c-lydia/SmartDB/smart_db_v2/smart_db/work/proposal.txt

                                                                 SmartDB ITC

 មាតិកា

   I.   ្របតិបត�ិសេង�ប (Executive Summary)………………………………………………………… 2
  II.   េសចក�ីែថ�ងពីប�� (Problem Statement)……………………………………………………… 2
 III.   ដំេណាះ្រសយ (Propose Solution)…………………………………………………………….. 3

        3.1 រេបៀបដំេណីរករៃនឧបករណ៏SmartDB…………………………………………………………………3

        3.2 អំពក
               ី ម�វ ិធទ
                       ី ូរស័ព�(Mobile App)…………………………………………………………………………4

        3.3 អ�ីែដលេធ�ីឲ្យ SmartDB ខុសពីឧបករណ៍ែផ្សងៗ……………………………………………………….5

 IV.    ែផនករគេ្រមាង (Project Plan)…………………………………………………………………..5
         4.1 ដំណាក់កលៃនគេ្រមាង……………………………………………………………………………….7
         4.2 តរងេពលេវលគេ្រមាង………………………………………………………………………………7

         4.3 ត្រម�វករធនធាន………………………………………………………………………………………..15

  V.    ភាគីពក់ព័ន� និងគំរូអជីវកម� (Stakeholders) …………………………………………………16
 VI.    ករ្រគប់្រគងហនិភ័យ (Risks Management)………………………………………………...20
VII.    ែផនករវយតៃម� (Evaluation Plan)……………………………………………………………21
VIII.   េសចក�ីសន�ិដ�ន (Conclusion)…………………………………………………………………..22
 IX.    ឧបសម�័ន� (Appendix)…………………………………………………………………………….22

                                                                         1|

                                                                                           SmartDB ITC

I.     ្របតប
           ិ ត�ស
               ិ េង�ប

      ប��ែខ្សេភ�ីងក�ុងផ�ះគឺជាមូលេហតុចម្បងមួយែដលនាំឲ្យមានអគ�ីភ័យេនតមលំេនដ�នេនកម�ុជា េដយក�ុង
      ឆា� ំ២០២៤ មានករណីអគ�ីភ័យធ�ន់ធ�រចំនួន ៦០២ ករណី ែដលេកីនេឡីងយា៉ងខ� ំងេធៀបេទនឹងឆា� ំមុនែដល
                          ់ តិកុ �ងសហគមន៏េលី្រគ�សរចំនួន ៤៣្រគ�សរបានបង�ញថា ៧៣.៨% ធា�ប់
      មាន៤៣២ ករណី ។ ករស�ងម
      ជួបប��ែខ្សេភ�ីង ប៉ុែន� ៦០.៥% មិនមាន្របព័ន�្រត�តពិនិត្យតមេពលេវលជាក់ែស�ង (Real-time
      Monitoring) េនេឡីយេទ។

      គេ្រមាងេនះបង�ញពី SmartDB ែដលជា្របព័ន�្រត�តពិនិត្យ និងករពរែខ្សេភ�ីងក�ុងផ�ះេដយេ្របីបេច�កវ ិទ្យោ
      IoT (Internet of Things) ែដល្រត�វបានរចនាេឡីងេដីម្បីរកេឃីញប��មុនេពលវក�យជាេ្រគាះថា�ក់។
      ្របព័ន�េនះរួមប��ូ លឧបករណ៍ចប់ស��ចរន� និងកេមរ៉ កេម� (Thermal Camera) ភា�ប់ជាមួយ
      Microcontroller ESP32, Firebase (Cloud Backend) និងកម�វ ិធីទូរស័ព� (Mobile Application) េដីម្បី
      ផ�ល់ករ្រត�តពិនិត្យតមេពលេវលជាក់ែស�ង និងករករពរេដយស�័យ្របវត�ិ។

      លក�ណៈពិេសសសំខន់ៗរួមមាន៖

      - ករ្រត�តពិនិត្យតមេពលេវលជាក់ែស�ងៃនចរន� និងសីតុណ�ភាព

      - ករជូនដំណឹងភា�មៗតមទូរស័ព�េនេពលរកេឃីញស�នភាពខុស្រប្រកតី

      - ករេបីកដំេណីរករឧបករណ៍កត់េសៀគ�ី (Circuit Breaker) េដយស�័យ្របវត�ិកុ �ងកំឡុងេពលមានប��
      ធ�ន់ធ�រ

      - ករចូលេ្របីេលខទំនាក់ទំនងសេ�ង�ះបនា�ន់េដយផា�ល់តមរយៈកម�វ ិធីទូរស័ព�

      តមរយៈករផ�ល់ករ្រពមានជាមុន និងករករពរេដយស�័យ្របវត�ិ ្របព័ន�េនះមានេគាលបំណងកត់បន�យ
                           � លមកពីែខ្សេភ�ីងេនតម្រគ�សរកម�ុជា និងជំរុញករេ្របី្របាស់ដំេណាះ្រសយ
      ហនិភ័យៃនអគ�ីភ័យែដលបណា
      សុវត�ិភាពផ�ះឆា�តៃវ (Smart Home Safety Solutions) ឲ្យកន់ែតទូលំទូលយ។

II.    េសចក�ែី ថ�ងពប
                   ី ��

       ប��ែខ្សេភ�ង
                ី ក�ុងផ�ះដូចជា ករផ�ុកេលស
                                        ី ទម�ន់ (Overloads), េសៀគ�ខ
                                                                  ី �ី (Short Circuits), ករេឡង
                                                                                              ី កេម�
       (Overheating) នង
                      ិ ករេលចធា�យចរន� (Current Leakage) គជា
                                                          ឺ មូលេហតុចម្បងៃនអគ�ភ
                                                                            ី ័យតមលំេន

                                                                                                          2|

                                                                                               SmartDB ITC

       ដ�ន។ េយាងតម្របភពព័ត៌មាន Cambodianess ករណីអគ�ីភ័យធ�ន់ធ�រេនកម�ុជាបានេកីនេឡីងយា៉ងខ� ំង
       ក�ុងឆា� ំ២០២៤ េដយមានរបាយករណ៍ចំនួន ៦០២ ករណី ែដលេកីនេឡីងយា៉ងខ� ំងេធៀបនឹងឆា� ំមុនែដល

                                           � លមកពីប��ែខ្សេភ�ីងដូចជា ករដំេឡីងមិន្រតឹម្រត�វ
       មានចំនួន ៤៣២ ករណី េដយមូលេហតុចម្បងបណា
       និងករេធ�ស្របែហស [1]។ប��ទំងេនះេ្រចីនែតេកីតេឡីងេដយគា�នករ្រពមានជាមុនេធ�ីឲ្យមា�ស់ផ�ះពិបាក
       រកេឃីញទន់េពលេវល។ ្របព័ន�ករពរែខ្សេភ�ីងែបប្របៃពណី ដូចជា ឧបករណ៍កត់េសៀគ�ី (Circuit
       Breakers) មាន្របតិកម�ែតេនេពលែដលប��េកីតេឡីងរួចេហីយប៉ុេណា�ះេហីយមិនផ�ល់ករ្រត�តពិនិត្យ
       តមេពលេវលជាក់ែស�ង ឬករជូនដំណឹងជាមុនេឡីយ។

       ករស�ង់មតិមួយែដលេធ�ីេឡីងេនក�ុងសង�ត់របស់ពួកេយីងេដយមានអ�កេឆ�ីយតបចំនួន ៤៣ នាក់ េដីម្បី
       កំណត់ប��ែខ្សេភ�ីងែដលមា�ស់ផ�ះកម�ុជាកំពុងជួប្របទះ បានបង�ញថា ៧៣.៨% ៃនអ�កេឆ�ីយតប (៤៣
       នាក់) បានរយករណ៍ថាធា�ប់ជួបប��ែខ្សេភ�ីងក�ុងផ�ះ។ ក�ុងចំេណាមអ�កេឆ�ីយតបចំនួន ៣៩ នាក់ែដលរង
       ផលប៉ះពល់េនះ ៣៥.៩% ធា�ប់ជួបប��េឡីងកេម�, ៤៥.៩% មានឧបករណ៍អគ�ិសនីខូចខត ឬបាក់ែបក,
       ២៩.៧% ធា�ប់ជួបករដច់េភ�ីងញឹកញាប់, ២៤.៣% ធុំកិ�នេឆះេចញពី្របព័ន�ែខ្សេភ�ីង និង ៥.៤% ធា�ប់ជួប
       េផ�កបេនា�រ ឬអគ�ីភ័យពីែខ្សេភ�ីង។ េលីសពីេនះេទៀត ៦០.៥% ៃនអ�កេឆ�ីយតបមិនមាន្របព័ន�្រត�តពិនិត្យ
       តមេពលេវលជាក់ែស�ងេទ េហយ                ី ំណងចង់មាន្របព័ន�្រត�តពន
                              ី ជាង៩០%បានបង�ញពប                       ិ ត
                                                                         ិ ្យែដលអចផ�ល់
       ទន
        ិ �ន័យតមេពលេវលជាក់ែស�ងេនេពលមានភាពខុស្រប្រកតេី កត
                                                          ី េឡង
                                                              ី ។

       ដូេច�ះ ចំបាច់្រត�វមាន្របព័ន�្រត�តពន
                                          ិ ត
                                            ិ ្យែខ្សេភ�ង
                                                      ី ឆា�តៃវេដយែផ�កេលប
                                                                        ី េច�កវ ិទ្យោ IoT ែដលអច្រត�តពន
                                                                                                      ិ ត
                                                                                                        ិ ្យ
       ្របព័ន�ែខ្សេភ�ង
                     ី ក�ុងផ�ះរបស់អ�កជាបន�បនា�ប់ រកេឃញ
                                                     ី ភាពខុស្រប្រកតដ
                                                                    ី ូចជា ករេឡង
                                                                                ី កេម�នង
                                                                                        ិ ផ�ល់ទន
                                                                                               ិ �ន័យ
       តមេពលេវលជាក់ែស�ងែដលជួយឲ្យមា�ស់ផ�ះដឹងពស
                                              ី � នភាពផ�ះជានច
                                                            ិ �។

III.   ដំេណាះ្រសយ

       េដីម្បេី ដះ្រសយប��អគ�ភ
                             ី ័យតមលំេនដ�នែដលបណា
                                                  � លមកពប
                                                        ី ��ែខ្សេភ�ង
                                                                   ី ដូចជា ែខ្សេភ�ង
                                                                                 ី េឡង
                                                                                     ី កេម�
       នង
        ិ ឥរយាបថខុ
            ិ      ស្រប្រកតរី បស់ឧបករណ៍ ពួកេយង      ី ូវដំេណាះ្រសយមួយែដលមានេឈ�ះថា
                                             ី សូមេស�ន
       SmartDB ែដលជា្របព័ន�្រត�តពន
                                 ិ ត
                                   ិ ្យ នង
                                         ិ ករពរែខ្សេភ�ង
                                                       ី ក�ុងផ�ះេដយេ្របប
                                                                        ី េច�កវ ិទ្យោ IoT ឆា�តៃវ ែដល្រត�វ
       បានរចនាេឡង
                ី េដីម្បរី កេឃញ
                              ី ស�នភាពែខ្សេភ�ង
                                             ី ែដលមានេ្រគាះថា�ក់កុ �ងេពលេវលជាក់ែស�ង នង
                                                                                      ិ េធ�ី
       អន�រគមន៍េដយស�័យ្របវត�ម
                             ិ ុនេពលវវ ិវត�ន៍េទជាអគ�ភ
                                                      ី ័យ។

       3.1 រេបៀបដំេណីរករៃនឧបករណ៏SmartDB

       SmartDB តមដន្របព័ន�ែខ្សេភ�ង
                                  ី ក�ុងផ�ះជាបន�បនា�ប់េដយេ្រប្រី បាស់ឧបករណ៍ចប់ស��ចរន� (Current
       Sensor - SCT-013-000) នង
                              ិ កេមរ៉ កេម� (Thermal Camera - MLX90640)។ ឧបករណ៍ចប់ស��

                                                                                                           3|

                                                                                  SmartDB ITC

ចរន�វស់ចរន�អគ�ិសនីែដលហូរតមេសៀគ�ីកុ �ងផ�ះខណៈែដលកេមរ៉ កេម�ចប់សមាសធាតុែដលេឡីងកេម�
ខ� ំង និងលំនា ំសីតុណ�ភាពខុស្រប្រកតី។

ទិន�ន័យែដល្របមូលបាន្រត�វបានដំេណីរករេដយMicrocontroller ESP32 និងវ ិភាគេដយេ្របីមូ៉ែដលរក
េឃីញភាពខុស្រប្រកតីេដយែផ�កេលីប��សិប្បនិមិ�ត (AI-based Anomaly Detection)។ ទិន�ន័យអគ�ិស

នីមួយៗ្រត�វបានវយតៃម�រកលំនា ំចរន�ខុស្រប្រកតី ខណៈែដលរូបភាពកេម�្រត�វបានវ ិភាគេដីម្បីកំណត់អត�
ស��ណចំណុចេក� (Hotspots)។ ្របព័ន� Jetson Nano ្រត�វបានេ្របីេដីម្បីគា ំ្រទករវ ិភាគកេម�ក្រមិត
ខ�ស់ និងដំេណីរករ AI។

េនេពលរកេឃីញស�នភាពខុស្រប្រកតី ្របព័ន�នឹងេផ�ីករជូនដំណឹង (Alert Notification) ភា�មៗេទកន់
មា�ស់ផ�ះតមរយៈកម�វ ិធីទូរស័ព�។ ្របសិនេបីប��ឈនដល់ក្រមិតធ�ន់ធ�រ ម៉ូឌុលប��ូ នត (Relay Module)
នឹងកត់ផា�ច់ថាមពលពីេសៀគ�ីែដលរងផលប៉ះពល់េដយស�័យ្របវត�ិ េដីម្បីករពរេ្រគាះថា�ក់ែដលអចេកីត
មាន និងកត់បន�យហនិភ័យែដលេកីតពីអគ�ីភ័យែខ្សេភ�ីង។

3.2 អំពក
       ី ម�វ ិធទ
               ី ូរស័ព�

កម�វ ិធទ
       ី ូរស័ព�ែដលភា�ប់មកជាមួយេនះេដីរតួជាចំណុច្របទក់ស្រមាប់មា�ស់ផ�ះក�ុងករេមល
                                                                             ី េឃញ
                                                                                 ី ពស
                                                                                    ី �ន
ភាព្របព័ន�ែខ្សេភ�ង
                ី របស់ពួកេគ។ វបង�ញតួរេលខករអនតៃម�ផា�ល់ (Live Readings) ៃនចរន� នង
                                                                                  ិ
 ិ �ន័យកេម� បង�ញករជូនដំណឹងអំពភា
ទន                              ី ពខុស្រប្រកតត
                                             ី មេពលេវលជាក់ែស�ង រួមជាមួយករចត់ថា�ក់
ប�� (Fault Classification) នង
                            ិ រក្សោទុកកំណត់េហតុៃនសកម�ភាពអគ�ស
                                                           ិ នក
                                                              ី ន�ងមក (Historical Log)
។ ក�ុងស�នភាពសេ�ង�ះបនា�ន់ កម�វ ិធេី នះក៏ផ�ល់េលខទំនាក់ទំនងសេ�ង�ះបនា�ន់េដយផា�ល់ ែដលអនុ��ត
ឲ្យមា�ស់ផ�ះអចទក់ទងេសវកម�ពក់ព័ន�បានយា៉ងរហ័សេដយ្រគាន់ែតចុចម�ងប៉ុេណា�ះ។

លក�ណៈពេិ សសសំខន់ៗ

- ករ្រត�តពន
           ិ ត
             ិ ្យជាបន�បនា�ប់ (Continuous Monitoring): វស់ចរន�អគ�ស
                                                                 ិ នក
                                                                    ី ុ �ងផ�ះតមេពលេវលជាក់
          ិ រ ំខនដល់ករផ�ត់ផ�ង់ថាមពល
ែស�ង េដយមន

- កររកេឃញ
         ី ចំណុចេក�កេម� (Thermal Hotspot Detection): កំណត់អត�ស��ណសមាសធាតុែដល
េឡង
  ី កេម�ខ� ំង មុនេពលវក�យជាេ្រគាះថា�ក់

- កររកេឃញ
         ី ភាពខុស្រប្រកតេី ដយប��សប
                                  ិ ្បនម
                                       ិ ិ�ត (AI Anomaly Detection): រកេឃញ
                                                                         ី លំនា ំប��
ែដលលក់កំបា ំង ែដល្របព័ន�កំណត់តៃម�ធម�ត (Threshold Systems) មន
                                                             ិ អចរកេឃញ
                                                                      ី បាន

- ករបំែបកេសៀគ�េី ដយស�័យ្របវត�ិ (Automatic Circuit Isolation): ប��ូ នត (Relay) កត់ផា�ច់
ថាមពលភា�មៗេនេពលរកេឃញ
                    ី ប�� េដយមន
                               ិ ចំបាច់មានករេធ�អ
                                                ី ន�រគមន៍ពអ
                                                           ី �កេ្រប្រី បាស់

                                                                                                4|

                                                                                     SmartDB ITC

- ករជូនដំណឹងតមេពលេវលជាក់ែស�ង (Real-time Alerts): េផ�ីករជូនដំណឹងរុញ (Push
Notifications) ភា�មៗេទកន់មា�ស់ផ�ះេនេពលរកេឃីញភាពខុស្រប្រកតី

- ករចូលេ្របីេលខទំនាក់ទំនងសេ�ង�ះបនា�ន់ (Emergency Contact Access): ចុចែតម�ងេដីម្បីេហេស
វសេ�ង�ះបនា�ន់េដយផា�ល់ពីកម�វ ិធី

- ករកត់្រត្របវត�ិទិន�ន័យ (Historical Data Logging): រក្សោទុកករអនតៃម� និងករជូនដំណឹងកន�ង
មកេនក�ុង Firebase ស្រមាប់ឲ្យមា�ស់ផ�ះពិនិត្យេឡីងវ ិញ

- ករទញេសចក�ីសន�ិដ�នែដលអចេធ�ីមា្រតដ�នបាន (Scalable Inference) Jetson Nano អនុ��ត
ឲ្យមានករទញេសចក�ីសន�ិដ�នពីមូ៉ែដល (Model Inference) ក្រមិតខ�ស់ ែដលេលីសពីសមត�ភាពរបស់
ESP32

3.3 អ�ែី ដលេធ�ឲ
             ី ្យ SmartDB ខុសពឧ
                              ី បករណ៍េផ្សងៗ

ឧបករណ៍កត់េសៀគ�ី (Circuit Breakers) ែបប្របៃពណីែដលមាន្របតិកម�ែតេនេពលែដលប��េកីត
េឡង
  ី រួចេហយ
         ី ប៉ុេណា�ះ េដយមន
                         ិ ផ�ល់ករស��្របាប់ជាមុនេឡយ
                                                  ី ។ ឧបករណ៍េដតឆា�តៃវ (Smart
Plugs) ស្រមាប់អ�កេ្រប្រី បាស់អច្រត�តពន
                                      ិ ត
                                        ិ ្យតមរន�េដតនម
                                                       ី ួយៗ ប៉ុែន�ខ�ះករករពរេដយស�័យ្របវត�ិ នង
                                                                                                ិ
ករ្រត�តពន
         ិ ត
           ិ ្យកេម�។ SmartDB រួមប��ូ លករ្រត�តពន
                                                ិ ត
                                                  ិ ្យចរន� នង
                                                            ិ កេម�ជាបន�បនា�ប់ ជាមួយនង
                                                                                     ឹ កររក
េឃញ
  ី ភាពខុស្រប្រកតេី ដយប��សប
                           ិ ្បនម
                                ិ �ត
                                   ិ (AI) េដីម្បច
                                                ី ប់ប��មុនេពលវេកន
                                                                 ី េឡង
                                                                     ី ជាេ្រគាះថា�ក់
បនា�ប់មកកត់ផា�ច់ថាមពលេដយស�័យ្របវត�ិ េដយមន
                                           ិ ចំបាច់មានករេធ�អ
                                                            ី ន�រគមន៍ពអ
                                                                       ី �កេ្រប្រី បាស់េឡី
យ។

IV. ែផនករគេ្រមាង
4.1 ដំណាក់កលៃនគេ្រមាង

           ឹ ្រត�វបានអនុវត�ជាដំណាក់កលជាេ្រចន
គេ្រមាងេនះនង                                ី េដីម្បធា
                                                    ី នាបាននូវករអភវិ ឌ្ឍ នង
                                                                           ិ ករវយតៃម�
្របកបេដយ្របព័ន�ៃន្របព័ន�្រត�តពន
                               ិ ត
                                 ិ ្យ នង
                                       ិ ករពរែខ្សេភ�ង
                                                      ី េដយេ្របប
                                                                ី េច�កវ ិទ្យោ IoT ែដលបានេស�េី ឡង
                                                                                               ី ។

ដំណាក់កលទី ១: ករកំណត់ប�� នង
                            ិ ករ្រសវ្រជាវ (Problem Identification and Research)

ករ្រសវ្រជាវអក្សរសល                           ិ ករស�ង់មតន
                   ិ ្ប ៍ (Literature Review) នង          ិ ង
                                                            ឹ ្រត�វបានេធ�េី ឡង
                                                                             ី េដីម្បក
                                                                                     ី ំណត់អត�
ស��ណប��សុវត�ភា       ី ក�ុងផ�ះទូេទ ដំេណាះ្រសយែដលមាន្រសប់ នង
            ិ ពែខ្សេភ�ង                                      ិ ត្រម�វកររបស់អ�កេ្រប្រី បា
ស់។ ព័ត៌មានែដល្របមូលបាននង
                        ឹ ្រត�វបានេ្របេី ដីម្បក
                                              ី ំណត់េគាលបំណងគេ្រមាង នង
                                                                     ិ ត្រម�វករ្របព័ន�។

                                                                                                 5|

                                                                                 SmartDB ITC

ដំណាក់កលទី ២: កររចនា្របព័ន� (System Design)

ស�បត្យកម�្របព័ន�ទ ំងមូល (System Architecture) សមាសធាតុែផ�ករង
                                                             ឹ (Hardware Components)
រចនាសម�័ន�មូលដ�នទន
                  ិ �ន័យ (Database Structure) នង
                                               ិ លំហូរករងររបស់កម�វ ិធទ
                                                                       ី ូរស័ព� (Mobile
Application Workflow) នង
                       ឹ ្រត�វបានរចនាេឡង
                                       ី ។ សមាសធាតុែផ�ករងដូ
                                                        ឹ ចជា ឧបករណ៍ចប់ស��
(Sensors), ESP32 នង
                  ិ យន�ករឧបករណ៍កត់េសៀគ�ី (Circuit Breaker Mechanisms) នង
                                                                         ឹ ្រត�វបាន
េ្រជីសេរសេដយែផ�
        ី        កេលត
                    ី ្រម�វករគេ្រមាង។

ដំណាក់កលទី ៣: ករអភិវឌ្ឍែផ�ករ ឹង ( Hardware Development)

ឧបករណ៍្រត�តពន
            ិ ត
              ិ ្យ (Monitoring Device) នង
                                        ឹ ្រត�វបានអភវិ ឌ្ឍេដយកររួមប��ូ លឧបករណ៍ចប់ស��
ចរន� នង
      ិ កេមរ៉ ចប់សត
                     ី ុណ�ភាពជាមួយMicrocontroller ESP32។ យន�ករឧបករណ៍កត់េសៀគ�ក
                                                                              ី ៏នង
                                                                                  ឹ ្រត�វ
បានប��ូ លផងែដរ េដីម្បីផ�ល់ករករពរេដយស�័យ្របវត�ិកុ �ងកំឡុងេពលមានស�នភាពែដលែខ្សេភ�ីងមាន
ប��អចបង�េទជាអគ�ីភ័យ ឬេ្រគាះថា�ក់េផ្សងៗ។
ដំណាក់កលទី ៤: ករអភិវឌ្ឍែផ�កទន់ ( Software Development)

កម�វ ិធីទូរស័ព� (Mobile Application) នឹង្រត�វបានអភិវឌ្ឍេដីម្បីបង�ញទិន�ន័យអគ�ិសនីតមេពលេវលជាក់
                       ំ ឹ ង (Alert Notifications) និងអនុ��តឲ្យអ�កេ្របី្របាស់ចូលេ្របីព័ត៌មាន
ែស�ង បំពក់ជាមួយករជូនដណ
ទំនាក់ទំនងសេ�ង�ះបនា�ន់។ Firebase នឹង Cloud Backend ស្រមាប់ករផ�ុកទិន�ន័យ និងករេធ�ីសមកល
កម� (Synchronization)។

ដំណាក់កលទី ៥: កររួមប��ូ ល្របព័ន� ( System Integration)

ឧបករណ៍ែផ�ករ ឹង (Hardware Device), មូលដ�នទិន�ន័យ Firebase និងកម�វ ិធីទូរស័ព� (Mobile
Application) នឹង្រត�វបានរួមប��ូ លគា� េដីម្បីបេង�ីតករទំនាក់ទំនងតមេពលេវលជាក់ែស�ងរវង្របព័ន�
្រត�តពិនិត្យ និងអ�កេ្របី្របាស់។

ដំណាក់កលទី ៦: ករេធ�ីេតស� និងវយតៃម� (Testing and Evaluation)

្របព័ន�នឹង្រត�វបានេធ�ីេតស�េ្រកមលក�ខណ�អគ�ិសនីេផ្សងៗ រួមទំងករផ�ុកេលីសទម�ន់ (Overload) និងករ
េឡីងកេម� (Overheating)។ ដំេណីរករៃនយន�ករ្រត�តពិនិត្យ (Monitoring), ករជូនដំណឹង (Alert)
និងករករពរ (Protection) នឹង្រត�វបានវយតៃម�េដយែផ�កេលីេពលេវលេឆ�ីយតប (Response
Time), ភាពេជឿជាក់ (Reliability) និងភាព្រតឹម្រត�វ (Accuracy)។

                                                                                               6|

                                                                                 SmartDB ITC

ដំណាក់កលទី ៧: ករវ ិភាគ និងឯកសរ (Analysis and Documentation)

លទ�ផលៃនករេធ�ីេតស�នឹង្រត�វបានវ ិភាគ និងចង្រកងជាឯកសរ។ ្របសិទ�ភាពៃន្របព័ន�ែដលបានេស�ីេឡីង
ក�ុងករែកលម�សុវត�ិភាពែខ្សេភ�ីងក�ុងផ�ះ និងកត់បន�យហនិភ័យនឹង្រត�វបានវយតៃម�។

4.2 តរងេពលេវលគេ្រមាង

4.3 ត្រម�វករធនធាន
1.    Hardware

     េលខ.រ       បេច�កវ ិទ្យោ               រូបភាព                       េគាលបំណង

        1        Jetson Orin Nano                                        ដំេណីរករ YOLO
                 Developer Kit                                           Inference ស្រមាប់ចប់
                                                                         យកកេម� (Thermal
                                                                         Detection) េលីប��ែខ្ស
                                                                         េភ�ីង

                                                                                          7|

                                    SmartDB ITC

2   កេមរ៉ កេម�            ប��ូ លទិន�ន័យ (Input)
    (Thermal Camera -        ស្រមាប់កររកេឃីញកេម�
    MLX90640)

3   ESP32 Developer Kit      ដំេណីរករ Firmware នង
                                                 ិ
    v1 (Expressive           ជា Edge Processor
    ESP32
    Microcontroller)

4   ថ� (Battery - 3.7V Li-   ផ�ត់ផ�ង់ថាមពលដល់
    ion 21700 ទំហំ           ESP32, ADS1115 នង
                                             ិ
    5000mAh)                 MLX90640 ក�ុងេពលដច់
                             េភ�ង
                                ី

                                             8|

                                                    SmartDB ITC

5   ម៉ូឌុលករពរករសកថ�                       សកថ�ពីចរន� 5V ករពរ
    (Charging                                  ករសកេលីស និងករ
    Protection Module -                        បេ�� ញថាមពលេលីស
    CN3791 ជាមួយករ
    ករពរ)

6   ឧបករណ៍បំែប�ងកមា� ំង                        បំែប�ងតង់ស្យុងថ�េឡង
                                                                 ី
    (Boost Converter -                               ី �ត់ផ�ង់ថាមពលេទ
                                               េដីម្បផ
    3.7V េទ 5V Boost)                         ប��ូ ល AMS1117

7   ឧបករណ៍ចប់ស��                              វស់ចរន�ចូល
    ចរន� (Current
    Sensor - SCT-013-
    000)

8   SmartDB Breakout       N/A (មិនទន់រចនា)   PCB េមស្រមាប់ភា�ប់ែផ�ក
    PCB (ផលិតតម                               ទំងអស់
    បំណង)
9   សមាសធាតុសកម� និង       N/A                 សមាសធាតុសកម� និងអ
    អកម�                                       កម�ស្រមាប់ SmartDB
                                               Breakout PCB

                                                                9|

                                                      SmartDB ITC

10   Relay - Omron                               កត់ផា�ច់ Main Power
     G5LE-1-E                                    Inputស្រមាប់ស�នភាព
                                                 អសន�

11   PCB Protection -                            ករពរបន�ះ PCB
     Acrylic Conformal                           Breakout ពស
                                                           ី ំេណីម
     Coating

12   ្របអប់ដក់              N/A (មិនទន់រចនា)   ្របអប់ស្រមាប់ករពរ
     (Enclosure - េបាះពុម�                       សមាសធាតុ
     3D តមបំណង េ្របី
     PETG Filament)

                                                                  10 |

                                       SmartDB ITC

13   ែខ្សេភ�ីង (Wires - ែខ្ស   ែខ្សេភ�ីង និងករករពរែខ្ស
     េភ�ីងេមក្រមិត             េភ�ីង
     450/750V, PG7
     Cable Glands, Heat
     Shrink Sleeving,
     Ferrule)

                                                11 |

                                                                                         SmartDB ITC

        14         Fastener(M3 brass                                              ស្រមាប់ដំេឡីង និងភា�ប់
                   standoffs, heat-set
                   inserts, stainless
                   screws)

2.     Software

         បេច�កវ ិទ្យោ                                   េគាលបំណង

        Arduino IDE          អភិវឌ្ឍន៍ Firmware ស្រមាប់ ESP32

        React Native         អភវិ ឌ្ឍន៍កម�វ ិធទ
                                              ី ូរស័ព� (Mobile Application)

        Firebase             Cloud Backend នង
                                            ិ Database
        Figma                រចនា UI/UX និងេធ�ីគំរូ (Prototyping)

        Git/GitHub           ្រគប់្រគងកំែណ (Version Control) និងករសហករ
                             (Collaboration)

        JavaScript           អភិវឌ្ឍន៍កម�វ ិធីទូរស័ព�

        C/C++                ស្រមាប់សរេសរកម�វ ិធី ESP32

3.3.    ធនធានមនុស្ស
       សមាជិក្រក�ម             តួនាទី                                    ទំនួលខុស្រត�វ

       េឆង លីឌីយា៉             អ�កដឹកនាំគេ្រមាង នង
                                                 ិ វ ិស�ករហដែវ          រចនាស�បត្យកម�្របព័ន�
                               រ(Project Lead & Hardware                 (System Architecture)
                               Engineer)

                                                                                                  12 |

                                                                                          SmartDB ITC

         លី នីហ៊ង                  អ�កអភិវឌ្ឍន៍សុសែវរ(Software           អភិវឌ្ឍន៍កម�វ ិធីទូរស័ព� និងករ
                                    Developer)                            រួមប��ូ ល Firebase (Mobile
                                                                          App Development,
                                                                          Firebase Integration)

         សុម
           ឹ ដវ ី                  វ ិស�ករែផ�ករង
                                                ឹ (Hardware               អភវិ ឌ្ឍន៍ នង
                                                                                      ិ សកល្បង
                                    Engineer) នង
                                               ិ េរៀបចំឯកសរ              ផលត
                                                                            ិ ផល(Hardware
                                                                          Development & Testing)

         រ៉ មា៉ករ៉               អ�ករចនាUX/UI                          រចនាចំណុច្របទក់កម�វ ិធី
                                                                          ទូរស័ព� (Mobile App
                                                                          Interface)
         រន
          ិ សុភារ ី                 អ�ករចនា នង
                                             ិ បេ�� ញគំរូ 3D              រចនា្របអប់ ឬសម្បកករពរ
                                                                          ស្រមាប់ឧបករណ៍
                                                                          (Enclosure Design)

3.    គេ្រមាងថវ ិក
     ករចំណាយេទេលីHardware

     េឈ�ះសមា�រ:        ភាពេជឿជាក់            បរមា
                                                ិ             តៃម�កុ �ង       តៃម�            ្របភពទញ
                                                                                                    ិ
                                              ណ               មួយឯក           សរុប
                                                               ត($)          ($)

 Jetson Orin            Confirmed            1                249$           249$             seedstudi
 Nano                                                                                         o
 Developer kit

 Thermal                Estimated            1                56.76$         56.76            AliExpres
 Camera                                                                      $                s
 (MLX90640)

                                                                                                      13 |

                                                        SmartDB ITC

ESP32             Estimated   1       5.08$     5.08$     Alibaba
Developer kit
v1 (Espressif
ESP32
microcontroller
)

Current Sensor    Estimated   1       3.45$     3.45$     AliExpres
(SCT-013-                                                 s
000)

SmartDB           Estimated   1       N/A       5-15$     JLCPCB
breakout PCB
(custom
build)

Passive           Confirmed   1 set   N/A       5-10$     KhmerES
Components
(for PCB
build)

Relay(Omron       Estimated   1       2.86$     2.86$     DigiKey
G5LE-1-E)

PCB protection    Estimated   1       12.99$    12.99     Amazon
(Acrylic                      can               $
Conformal
Coating)

Enclosure         Estimated   1       10-20$    10-       Amazon
(custom 3D                            (materi   20$
printing, PETG                        al and
filament)                             labor)

                                                                 14 |

                                                             SmartDB ITC

450/750V rated   Estimated        As      0.3-0.5$   0.3-      Alibaba
mains wiring                      need               0.5$
                                  ed

PG7 cable        Estimated        3       7.99$      7.99$     Amazon
glands

Heat shrink      Confirmed        As      1.25$      1.25$     KhmerES
sleeving                          need
                                  ed

Ferrule          Estimated        1 set   9.99$      9.99$     Amazon

Fastener(M3      Confirmed        1 set   3$         3$        KhmerES
brass
standoffs,
heat-set
inserts,
stainless
screws)

Boost            Estimated        1       4.47$      4.47$     AliExpres
Converter                                                      s

Battery          Estimated        4       5.50$      22$       Alibaba

Charging         Estimated        1       1.98$      1.98$     AliExpres
Protection                                                     s
Module

 ករចំណាយេទេលីSoftware: មិនមាន
 . ថវ ិក្រត�វចំណាយសរុប

                                                                      15 |

                                                                                       SmartDB ITC

       េឈ�ះ                           តៃម�សរុប

       Hardware Cost                     416$

       Software Cost                       0$

       Total Budget Summary              416$

V.     ភាគព
          ី ក់ព័ន� នង
                    ិ គំរូអជីវកម�
      1. អ�កទទួលផល្របេយាជន៍ចម្បង
      អ�កទទួលផល្របេយាជន៍ចម្បងៃនគេ្រមាងេនះគមា
                                          ឺ � ស់ផ�ះ នង
                                                     ិ ្រក�ម្រគ�សរែដលេ្រប្រី បាស់ SmartDB េដយ
      ផា�ល់៖
     - មា�ស់ផ�ះកម�ុជា (Cambodian Homeowners)៖ ទទួលបានករ្រត�តពន
                                                              ិ ត
                                                                ិ ្យតមេពលេវលជាក់ែស�ង
      (Real-time Monitoring), ករជូនដំណឹង (Alert Notifications) នង
                                                                 ិ ករករពរេដយស�័យ្របវត�ព
                                                                                          ិ េី ្រគាះ
      ថា�ក់ែខ្សេភ�ង
                  ី
     - ្រគ�សរែដលរស់េនតំបន់មាន្របជាជនេ្រចន
                                          ី (Families Living in Densely Populated Areas)៖ ទទួល
      បានអត�្របេយាជន៍ពក
                      ី ររកេឃញ           ី ទន់េដីមដំបូង ែដលកត់បន�យហនភ
                             ី ប��ែខ្សេភ�ង                             ិ ័យៃនអគ�ភ
                                                                               ី ័យផ�ះជា
      េ្រចន
          ី
     - អ�ករស់េនវ ័យចំណាស់ ឬអ�កែដលមន
                                   ិ សូវេចះបេច�កវ ិទ្យោ (Elderly or Less Tech-Savvy Residents)៖
      ទទួលបានសុវត�ភា
                  ិ ពបែន�មតមរយៈលក�ណៈពេិ សសឧបករណ៍កត់េសៀគ�េី ដយស�័យ្របវត�ិ (Automatic
      Circuit Breaker) សូម្បែី តេនេពលែដលមា�ស់ផ�ះមន
                                                  ិ េនក៏េដយ។

     2 . អ�កទទួលផល្របេយាជន៍បនា�ប់បន្សំ
      ភាគីពក់ព័ន�បនា�ប់បន្សំរួមមាន ជាងអគ�ិសនី (Electricians), អជា�ធរមូលដ�ន (Local Authorities)
      និងទីភា�ក់ងរេឆ�ីយតបសេ�ង�ះបនា�ន់ (Emergency Response Agencies) ែដលអចទទួលផល
      ្របេយាជន៍េដយ្របេយាលពី SmartDB៖
      - នាយកដ�នពន�ត់អគ�ីភ័យ៖ អចទទួលបានអត�្របេយាជន៍ពីករថយចុះៃនករណីអគ�ីភ័យែដលបណា
                                                                                � លមក
      ពីប��ែខ្សេភ�ីង
      - រដ�ភិបាលមូលដ�ន និងអជា�ធរ្រក�ង ៖ គាំ្រទដល់សុវត�ិភាពសធារណៈ និងគំនិតផ�ួចេផ�ីមទី្រក�ងឆា�តៃវ
      - ជាងអគ�ិសនី និងអ�កេម៉ ករអគ�ិសនី ៖ អចែណនាំ ឬដំេឡីង្របព័ន�េនះជូនមា�ស់ផ�ះ

                                                                                                  16 |

                                                                                           SmartDB ITC

      3. ករចូលរួមជាមួយភាគព
                          ី ក់ព័ន�
       មតែិ កលម�ពភា
                 ី គព       ឹ ្រត�វបាន្របមូលតមរយៈករស�ង់មតិ (Surveys), ករបង�ញគំរូ (Prototype
                    ី ក់ព័ន�នង
       Demonstrations) នង
                        ិ ករេធ�េី តស�េដយអ�កេ្រប្រី បាស់ (User Testing)។ មតែិ កលម�ែដល្របមូលបាន
       នង
        ឹ ្រត�វបានេ្រប្រី បាស់េដីម្បែី កលម�មុខងរ (Functionality), ភាពងយ្រស�លេ្របី (Usability) នង
                                                                                                 ិ ្របសទ
                                                                                                       ិ �
       ភាព (Effectiveness) ៃន្របព័ន�ែដលបានេស�េី ឡង
                                                 ី ។

VI.     ករ្រគប់្រគងហនភ
                       ិ ័យ

       គេ្រមាងេនះ្របឈមនង
                       ឹ ហនភ
                            ិ ័យចំនួន្របាំមួយ្របេភទ៖ បេច�កេទស ្របតប
                                                                  ិ ត�ក
                                                                      ិ រ ករ្រគប់្រគងគេ្រមាង ទី
       ផ្សោរ នង
              ិ ហរិ ��វត�ុ ។ ហនភ
                                ិ ័យនម
                                     ី ួយៗ្រត�វបានវយតៃម�ខងេ្រកមេនះតមលទ�ភាពេកត
                                                                                ី មាន នង
                                                                                       ិ ផលប៉ះ
       ពល់ រួមជាមួយយុទ�ស�ស�កត់បន�យែដល្រត�វគា�។

       បេច�កេទស

       • កររកមិនេឃីញកំហុស (false negative) េទះបីមានករផ្សំគា�ពី ML និង្រសទប់ច្បាប់ (rule-

       based) ក៏េដយ
       • ករបំពនសុវត�ិភាព DTLS ឬ PSK ែដលអចបណា
                                              � លឱ្យមានករវយ្របហរតមករចម�ងសរ
       (replay) ឬករែក�ងបន�ំពក្យប��បដិេសធ (override)
       • ករប៉ះទង�ិចេលីែខ្សប��ូ ន I2C ឬសំេឡងរ ំខនស��រវង ADS1115 និង MLX90640

       • ករបរជ័យៃនករដក់ឧបករណ៍ករពរ (isolation) េលី PCB រវងថាមពលចូល និងឧបករណ៍េ្របី

       ថាមពលទប
       • កំហុសកម�វ ិធី firmware ែដលបណា
                                     � លឱ្យេកីតមានករចប់េផ�ីមេឡីងវ ិញម�ងេហីយម�ងេទៀត ឬករេលច
       ធា�យmemory
       • ករែ្រប្រប�លៃនករគណនា (calibration) ែដល្រត�វករករែកត្រម�វក្រមិត្រពំែដនេឡីងវ ិញ

       ្របតិបត�ិករ

       • កំហុសក�ុងករផ�ុំេដយៃដក�ុងដំណាក់កលផលិតគំរូដំបូង

       • ករពន្យោរេពលក�ុងករទិញសមា�រៈ េដយសររយៈេពលនាំចូលេនកម�ុជា

       • ករេនឿយហត់របស់អ�កេ្របី្របាស់ េដយសរស��្រពមានមិនពិត (false positive)

       • ករដំេឡីងឧបករណ៍ែដល្រត�វករចំេណះដឹងែផ�កអគ�ិសនី ែដលមា�ស់ផ�ះភាគេ្រចីនមិនមាន

       • ករខ�ះខតខ្យល់េចញចូល្រគប់្រគាន់េនក�ុង្របអប់ឧបករណ៍ក�ុងស�នភាពេ្របី្របាស់ជាក់ែស�ង

                   � ញ/វ៉ យហ�យ (Wi-Fi) ក�ុងេពលដំេឡីងឧបករណ៍
       • ករផា�ច់បណា

                                                                                                      17 |

                                                                                      SmartDB ITC

  គេ្រមាង

  • ករយឺតយា៉វកលវ ិភាគេលីករបណុ � ះបណា
                                      � ល និងេផ� ងផា�ត់គំរូ AI
  • េពលេវលមិន្រគប់្រគាន់កុ �ងករសកល្បងឧបករណ៍មុនករបង�ញចុងេ្រកយ ឬករដក់ដំេណីរករ

  ទីផ្សោរ

  • ករទទួលយកទបេដយសរភាពមិនធា�ប់ស�ល់នឹងឧបករណ៍សុវត�ិភាពអគ�ិសនីែបបករពរទុកមុន

  • ភាពែ្រប្រប�លចំេពះតៃម�កុ �ង្រក�មអ�កេ្របី្របាស់េគាលេដ

  • ករ្របកួត្របែជងពីមា៉កយីេហែដលមានេឈ�ះក�ុងទីផ្សោ្រសប់ ែដលកំពុងព្រងីកេទេលីែផ�ក្រត�តពិនិត្យ

  ឆា�តៃវ
  • ករលំបាកក�ុងករកសងទំនុកចិត�កុ �ងនាមជាឧបករណ៍ថ�ីែដលេនមិនទន់មានភស�ុតងប��ក់ែផ�ក

  សុវត�ិភាព

  ហរិ ��វត�ុ

  •    ករែ្រប្រប�លតៃម�េ្រគឿងបនា�ស់ (Jetson Nano, MLX90640 សុទ�ែតជាសមា�រៈនាំចូល)
  •    ករចំណាយេលីករទក់ទញអតិថិជនេលីសពីករបា៉ន់ស�ន
  •    ក្រមត
           ិ តៃម� enterprise ែដលកំណត់ទបជាងតៃម�ផលត
                                                 ិ ផលពត
                                                      ិ ្របាកដ

  2. ករវយតៃម�ហនភ
                  ិ ័យ
  លទ�ភាព (Likelihood) នង
                       ិ ផលប៉ះពល់ (Impact) ្រត�វបានវយតៃម�េលមា
                                                             ី ្រតដ�នបក
                                                                       ី ្រមត
                                                                            ិ (ទប,
  មធ្យម, ខ�ស់) េដយែផ�កេលក
                         ី រចត់ត ំង្រក�មករងរ នង
                                                  ិ ករេ្របៀបេធៀបជាមួយគេ្រមាងែផ�ករង
                                                                                  ឹ IoT ្រស
  េដៀងគា�។ ក្រមត
               ិ ហនភ
                    ិ ័យ (Risk Level) ឆ�ុះប�� ំងពឥ
                                                 ី ទ�ព
                                                     ិ លរួមប��ូ លគា�ៃនលទ�ភាព នង
                                                                              ិ ផលប៉ះពល់។

                      Risk                         Category     Likelihood   Impact     Risk level

      False negative on fault detection            Technical    Medium        High        High

DTLS or PSK compromise enabling spoofed            Technical      Low         High      Medium
                       override
             Hand-assembly defects                Operational   Medium       Medium     Medium

            Component sourcing delay              Operational     High       Medium     Medium

                                                                                                 18 |

                                                                                     SmartDB ITC

               Operator alert fatigue               Operational    Medium    Medium     Medium

     Timeline slippage on AI model training            Project     Medium     High        High

               Low market adoption                     Market      Medium     High        High

            Component price volatility               Financial     Medium    Medium     Medium

        Electrical safety certification gap          Regulatory      Low      High      Medium

     Liability exposure on missed detection          Regulatory      Low      High      Medium

3. យុទ�ស�ស�កត់បន�យហនិភ័យ
តរងខងេ្រកមបង�ញពីករផ�ូផ�ងហនិភ័យអទិភាពខ�ស់ (High-priority Risks) នីមួយៗជាមួយនឹងយុទ�ស
      �ស�កត់បន�យ (Mitigation Strategy) ែដល្រត�វគា�។ យុទ�ស�ស�កត់បន�យជាេ្រចីន្រត�វបានេដះ្រសយ
      េដយផា�ល់េដយស�បត្យកម�្របព័ន� (System Architecture) ជាជាងេដយដំេណីរករ្រគប់្រគងពីខង
      េ្រក (External Process Controls) ែដលឆ�ុះប�� ំងពីករសេ្រមចចិត�រចនា (Design Decisions) ែដល
      េធ�ីេឡីងជាពិេសសេដីម្បីកត់បន�យហនិភ័យ។

         ហនភ
            ិ ័យ                                          ករកត់បន�យ
 False negative on fault    Rule-based safety layer operates independently of AI inference
       detection                   ensuring detection continues even if ML models underperform

 DTLS or PSK                Sequence-number-based replay prevention and per-node pre-
       compromise                  shared keys limit the blast radius of any single compromised
                                   credential
 Hand-assembly defects      Visual inspection and continuity testing performed before powering
                                   on each assembled board
 Component sourcing         Critical components ordered at project start with a two-week buffer
       delay                       before the assembly phase begins
 Operator alert fatigue     Operator feedback loop retrains the anomaly detection model,
                                   reducing false positive rate over time

                                                                                                 19 |

                                                                                       SmartDB ITC

 Timeline slippage on Ai      Base-tier model development prioritized ahead of enterprise-tier
       training                     features to protect the core delivery timeline

 Low market adoption          Pilot deployment with early-adopter households to generate case
                                    studies ahead of wider launch
 Component price              Multiple supplier quotes obtained in advanced enterprise tier pricing
       volatility                   includes a margin buffer
 Electrical safety            Early consultation with the relevant Cambodian electrical authority to
       certification gap            clarify compliance requirements
 Liability exposure           Clear documentation of system limitations and recommended use
                                    alongside, not as a replacement for existing safety equipment

៨. ែផនករវយតៃម�

             ិ ័�យសេ្រមចេជាគជ័យ
8.1 លក�ណៈវ ិនច

1. សមត�ភាពបេច�កេទស

   • ្របព័ន�រកេឃីញកំហុសអគ�ិសនីេដយមានភាព្រតឹម្រត�វយា៉ងតិច ៩០%

   • រុ ឺេឡ (relay) ដំេណីរករេដយស�័យ្របវត�ិកុ �ងរយៈេពលេឆ�ីយតបែដលអចទទួលយកបាន ភា�មៗបនា�ប់ពី

      កររកេឃីញកំហុស
            ំ ឹ ងតមទូរស័ព�្រត�វបានប��ូ នក�ុងរយៈេពលប៉ុនា�នវ ិនាទីបនា�ប់ពីកររកេឃីញភាពមិន្រប្រកតី
   • ករជូនដណ

   • ្របព័ន�ដំេណីរករជាបន�បនា�ប់េដយគា�នករបរជ័យែដលមិនបានរ ំពឹងទុក

2. បទពិេសធន៍អ�កេ្របី្របាស់

   • កម�វ ិធីទូរស័ព�្រត�វបានវយតៃម�ជាមួយលទ�ផលវ ិជ�មានេដយអ�កសកល្បងេដីម្បីបេង�ីនភាពងយ្រស�លេ្របី

      និងភាពច្បាស់លស់
   • មា�ស់ផ�ះអចយល់ និងេឆ�ីយតបេទនឹងស��្រពមានេដយមិនចំបាច់មានចំេណះដឹងបេច�កេទស

                                                                                                   20 |

                                                                                        SmartDB ITC

3. ករ្របមូលទិន�ន័យ

3.1 ទិន�ន័យ្របព័ន�

   • ករអនតួរេលខពីឧបករណ៍ចប់ស��(Sensor) ្រត�វបានកត់្រតជាប់លប់កុ �ង Firebase ក�ុងេពលសក

        ល្បង
   • េពលេវលេឆ�ីយតបរវងកររកេឃីញកំហុស និងករដំេណីរកររុ ឺេឡ្រត�វបានកត់្រត

   • លទ�ផលពីករេធ�ីេតស� និងសកល្បង្រត�វបានចង្រកងជាឯកសរ ស្រមាប់វ ិភាគ

3.2 ទិន�ន័យអ�កេ្របី្របាស់

   • ករស�ង់មតិមុន និងេ្រកយេ្របី្របាស់ េដីម្បីវស់ស�ង់ករផា�ស់បូ �រេលីករយល់ដឹង និងករេពញចិត�របស់អ�ក

        េ្របី្របាស់
   • ករសេង�តេមីលអ�កេ្របី្របាស់េ្របី្របាស់កម�វ ិធីទូរស័ព�កុ �ងេពលសកល្បង

3.3 វដ�មត្រិ តឡប់

   • ករែចករ ំែលកគំរូកម�វ ិធីដំបូងជាមួយអ�កេ្របី្របាស់សក�នុពល េហីយែកស្រម�លកររចនាេដយែផ�កេលីមតិ

        ្រតឡប់មុនេពលផលិតចុងេ្រកយ
   • ករ្របមូលចេម�យ
                 ី តបពអ
                      ី �កេ្រប្រី បាស់បនា�ប់ពវី គ�សកល្បងនម
                                                          ី ួយៗ តមរយៈក្រមងសំណួរខ�ៗ
                                                                                 ី
   • ករបង�ញលទ�ផលដល់ភាគព
                        ី ក់ព័ន�បនា�ប់ពក
                                       ី រសកល្បង នង
                                                   ិ ចង្រកងជាឯកសរនូវសំណូមពរស្រមាប់
        ករែកលម�នាេពលអនាគត

VIII.   េសចក�ស
            ី ន�ដ
               ិ �ន

        ប��អគ�ស
              ិ នក
                 ី ុ �ងផ�ះគជា
                           ឺ ហនភ
                                ិ ័យសុវត�ភា
                                        ិ ពកំពុងេកន
                                                  ី េឡង
                                                      ី េនកម�ុជា េដយករណីអគ�ភ
                                                                             ិ ័យបានេកន
                                                                                      ី េឡង
                                                                                          ី
        ពី ៤៣២ ករណី ដល់ ៦០២ ករណីក�ុងឆា� ំ ២០២៤ ែតមួយឆា� ំបុ៉េណា�ះ។ ប៉ុែន�ផ�ះភាគេ្រចន
                                                                                   ី េនែតពង
                                                                                           ឹ ែផ�ក
        េលី circuit breaker ែដលជាឧបករណ៍ែបប្របៃពណី ែដលមន
                                                      ិ មានករ្រពមានជាមុន នង
                                                                           ិ គា�នករ្រត�តពន
                                                                                          ិ ិ
        ត្យតមេពលេវលជាក់ែស�ង។

        SmartDB េដះ្រសយប��េនះេដយផា�ល់ តមរយៈករ្រត�តពន
                                                        ិ ត
                                                          ិ ្យចរន�អគ�ស
                                                                    ិ នជា
                                                                       ី បន�បនា�ប់ កររកេឃញ
                                                                                          ី
        ចំណុចេក�េដយ្របព័ន�កេម� នង
                                   ិ កររកេឃញ
                                            ី ភាពមន
                                                  ិ ្រប្រកតេី ដយ AI។ េនេពលែដលហនភ
                                                                                  ិ ័យ្រត�វបាន
        រកេឃញ                                       ិ ជូនដំណឹងភា�មៗដល់មា�ស់ផ�ះ េដយមន
            ី ្របព័ន�កត់ផា�ច់ថាមពលេដយស�័យ្របវត�ិ នង                               ិ ្រត�វករ
        ចំេណះដឹងបេច�កេទសពអ
                         ី �កេ្រប្រី បាស់េឡយ
                                           ី ។

                                                                                                  21 |

                                                                                      SmartDB ITC

       េដយមាន្រគ�សរែដលបានស�ង់មតិជាង ៩០% បានបង�ញចំណាប់អរម�ណ៍ចំេពះ្របព័ន�្រត�តពិនិត្យែបប
       េនះ ែដលប��ក់ថា SmartDB ពិតជាមានត្រម�វករ និងជាដំេណាះ្រសយែដលអចអនុវត�បានស្រមាប់
       មា�ស់ផ�ះេនកម�ុជា។

       ករអំពវនាវឱ្យចូលរួម

       ពួកេយីងសូមេគារពអេ�� ីញគណៈវ ិនិច�័យ អ�កែណនាំ និងភាគីពក់ព័ន� គាំ្រទដល់ករអភិវឌ្ឍ និងករដក់ឱ្យ
       ដំេណីរករៃន SmartDB ជាដំេណាះ្រសយដ៏ជាក់ែស�ង មានតៃម�សមរម្យ និងមានឥទ�ិពលវ ិជ�មានចំេពះ
       សុវត�ិភាពអគ�ិសនីកុ �ងផ�ះេនកម�ុជា។

       ជំហនបនា�ប់ភា�មៗរបស់េយីងគឺ៖

       • ប�� ប់ករផ្សោរភា�ប់ែផ�ករ ឹង និងករគណនាឧបករណ៍ចប់ស��

       • ប�� ប់ករអភិវឌ្ឍកម�វ ិធីទូរស័ព� និងករសកល្បងជាមួយអ�កេ្របី្របាស់

      • េធ�ីករសកល្បង្របព័ន�េពញេលញក�ុងលក�ខណ�កំហុសែក�ងេធ�ី

      • បង�ញលទ�ផល និងែកលម�្របព័ន�េដយែផ�កេលីលទ�ផលវយតៃម�

                                                              ិ គំរូដំបូង
      • ែស�ងរកមាគា៌ស្រមាប់ករទទួលយកក�ុងសហគមន៍ទូលំទូលយជាងករផលត

      ជាមួយករគាំ្រទ្រតឹម្រត�វ SmartDB មានសក�នុពលឈនផុតពីដំណាក់កលគំរូដំបូង េហីយក�យជា
      ឧបករណ៍សុវត�ភា
                ិ ពែដលអចចូលេ្របបា
                                ី នពត
                                    ិ ្របាកដស្រមាប់្រគ�សរេនទូទ ំង្របេទសកម�ុជា កត់បន�យអគ�ិ
      ភ័យអគ�ស
            ិ នី ករពរ្រគ�សរ នង
                                ិ េលក
                                    ី កម�ស់ផ�ះែដលឆា�តៃវ នង
                                                         ិ មានសុវត�ភា
                                                                  ិ ពជាងមុន។

IX.     ឧបសម�័ន� (Appendix)
1. េសចក�ីសេង�បករស�ង់មតិ និងទិន�ន័យេដីម

                                                                                                22 |

SmartDB ITC

       23 |

                                                                                       SmartDB ITC

2. ស�បត្យកម�្របព័ន�

SmartDB មានស�បត្យកម�្របាំ្រសទប់៖

្រសទប់ចប់ស�� (Sensing Layer)

•     ឧបករណ៍ចប់ស��ចរន� SCT-013-000 វស់ចរន�អគ�ស
                                               ិ នក             ិ រ ំខនដល់ករផ�ត់ផ�ង់ថាមពល
                                                  ី ុ �ងផ�ះេដយមន
•     កេមរ៉ កេម� MLX90640 ថតចប់ករែចកចយកេម�ជាបន�បនា�ប់េនទូទ ំង្របព័ន�អគ�ស
                                                                                ិ នី

្រសទប់ដំេណីរករែគម (Edge Processing Layer)

•     ម្រី ក�កុន្រត�ល ESP32 ដំេណីរករទន
                                      ិ �ន័យចូលពឧ
                                                ី បករណ៍ចប់ស��
•     ្រសង់លក�ណៈអគ�ស
                   ិ នស
                      ី ំខន់ៗ នង
                                ិ តមដនករអនតៃម�េធៀបនង
                                                       ឹ ្រពំែដនសុវត�ភា
                                                                    ិ ព
•     ដំេណីរករកត់ផា�ច់រុេឡេដយស�
                           ឺ       ័យ្របវត�ភា
                                           ិ � មៗ ្របសន
                                                      ិ េបក
                                                          ី រអនតៃម�ណាមួយេលស
                                                                           ី ក្រមត
                                                                                 ិ សុវត�ភា
                                                                                       ិ ព

្រសទប់សន�ដ
          ិ � ន AI (AI Inference Layer)

•     គំរូ Isolation Forest រកេឃញ
                                ី លំនា ំមន
                                         ិ ្រប្រកតក
                                                  ី ុ �ងទន
                                                         ិ �ន័យអគ�ស
                                                                 ិ នី
•     គំរូ YOLO កំណត់អត�ស��ណចំណុចេក�ក�ុងរូបភាពកេម�
•     មា៉សុន
           ី ប��ូ លគា� (fusion engine) ផ្សំលទ�ផលទំងពរី េទជាពន
                                                              ិ ុ �ហនភ
                                                                      ិ ័យែតមួយ
•     Jetson Nano េដះ្រសយករសន�ដ
                                 ិ � នគំរូក្រមត
                                              ិ ខ�ស់េដីម្បភា
                                                          ី ព្រតម
                                                                ឹ ្រត�វខ�ស់ជាង

                                                                                              24 |

                                                                                    SmartDB ITC

្រសទប់ទំនាក់ទំនង (Communication Layer)

•       ESP32 ប��ូ នទិន�ន័យេទ Firebase តមេពលេវលជាក់ែស�ងតមរយៈ WiFi
•       Firebase រក្សោទុកករអនតៃម�ផា�ល់ ស��្រពមាន និងកំណត់្រត្របវត�ិកុ �ងពពក

្រសទប់កម�វ ិធី (Application Layer)

•       កម�វ ិធីទូរស័ព�បង�ញករអនតៃម�អគ�ិសនី និងកេម�ផា�ល់
•       េផ�ីស��្រពមានភា�មៗដល់មា�ស់ផ�ះេនេពលរកេឃីញភាពមិន្រប្រកតី
•       ផ�ល់ករចូលេ្របីទំនាក់ទំនងបនា�ន់្រតឹមែតមួយចុចក�ុងស�នភាពអសន�

                                                ប�ង់េសៀគ�ីអគ�ិសនី

3. កលវ ិភាគ

                    ដំណាក់កល                        រយៈេពល          កលបរ ិេច�ទ

    ដំណាក់កលទី ១: ្រសវ្រជាវ                       ៤ សបា�ហ៍        ឧសភា - មិថុនា

                                                                                           25 |

                                                                                  SmartDB ITC

 ដំណាក់កលទី ២: រចនា្របព័ន�                      ៤ សបា�ហ៍   ឧសភា - មិថុនា

 ដំណាក់កលទី ៣: អភិវឌ្ឍន៍ហដែវរ                  ២.៥ ែខ     កក�ដ - ក��

 ដំណាក់កលទី ៤: អភិវឌ្ឍន៍សុសែវរ                  ២.៥ ែខ     កក�ដ - ក��

 ដំណាក់កលទី ៥: រួមប��ូ ល្របព័ន� (Integration)   ២ សបា�ហ៍        ក��

 ដំណាក់កលទី ៦: េធ�ីេតស�                           ១ ែខ          តុល

 ដំណាក់កលទី ៧: វ ិភាគ និងឯកសរ                  ២ សបា�ហ៍    តុល - វ ិច�ិក

ឯកសរេយាង

[1] Cambodianess, ‘Fire Surge in Cambodia: 602 cases, 15 Dead in 8 Months,’ Cambodianess,
     2024. [Online]. Available: https://cambodianess.com/article/fire-surge-in-cambodia-602-
     cases-15-dead-in-8-months

                                                                                               26 |
