c-lydia/SmartDB/docs/reference/language_ref/preprocessor.md

# Preprocessor

Preprocessor: program that processes source code before compilation

## File Inclusion

``` c
#include "filename" // use when the file exists locally
#include <filename> // use for the standard C libraries
```

## Macro Substitution

``` c
#define name replacement_text
```

`name` will be replaced by `replacement_text` like how you assign values to variable

A long definition can be written by using a `\` at the end of the line

Substitution doesn't work for quoted string

``` c
#define forever for (;;) // infinite loop
#define max(a, b) ((a) > (b) ? (a) : (b)) 
/* looks like function invocation, but a and b will be replaced by values, e.g., x = max((p + q), (r + s)); will be replaced by x = ((p + q) > (r + s) ? (p + q) : (r + s)); */
```
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
