c-lydia/SmartDB/smart_db_v2/smart_db/work/back_labels_current.png

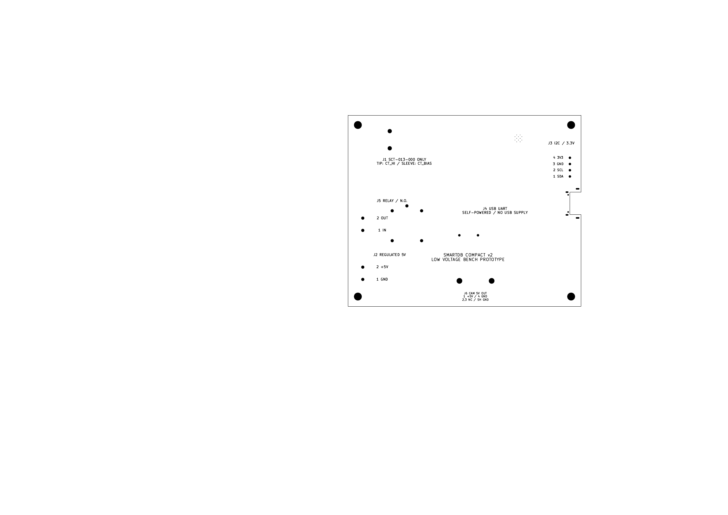
smart_db_v2/smart_db/work/back_labels_current.png
