c-lydia/SmartDB/smart_db_v2/smart_db/work/connectors_before.png

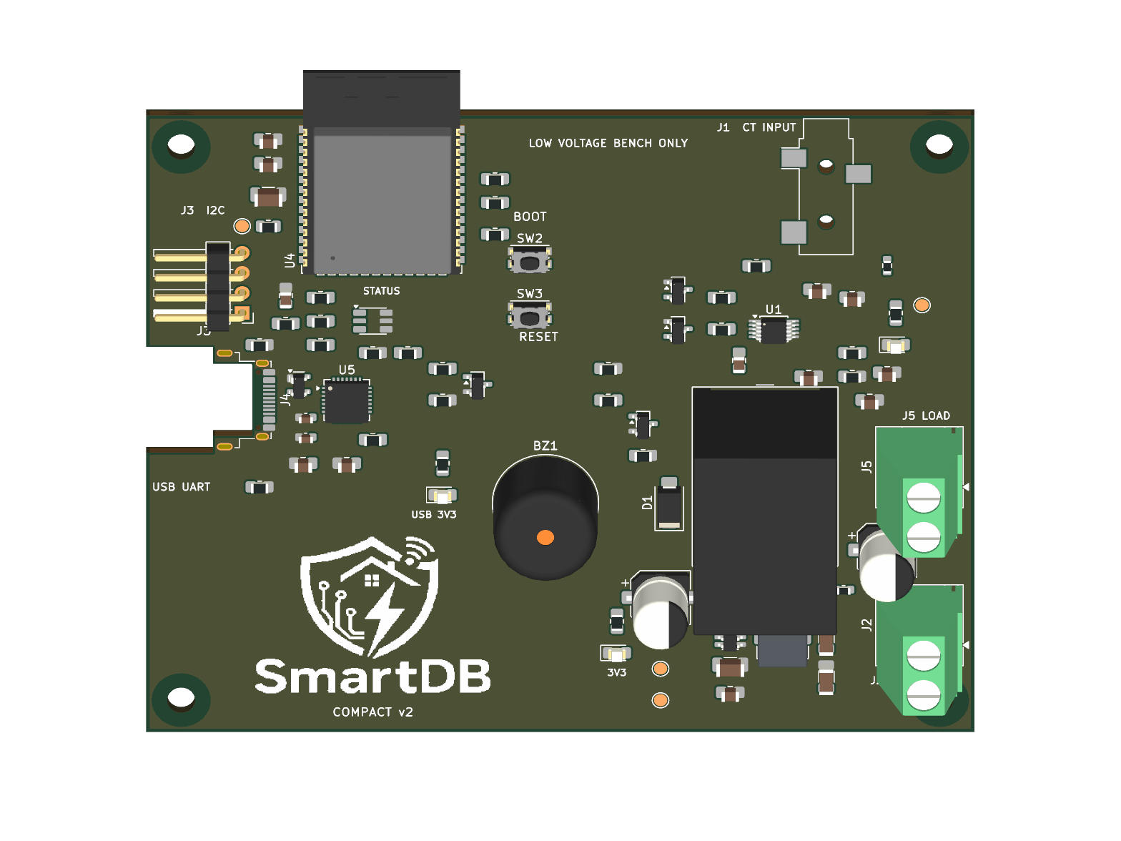
smart_db_v2/smart_db/work/connectors_before.png
