c-lydia/SmartDB/smart_db_v2/smart_db/work/placement.png

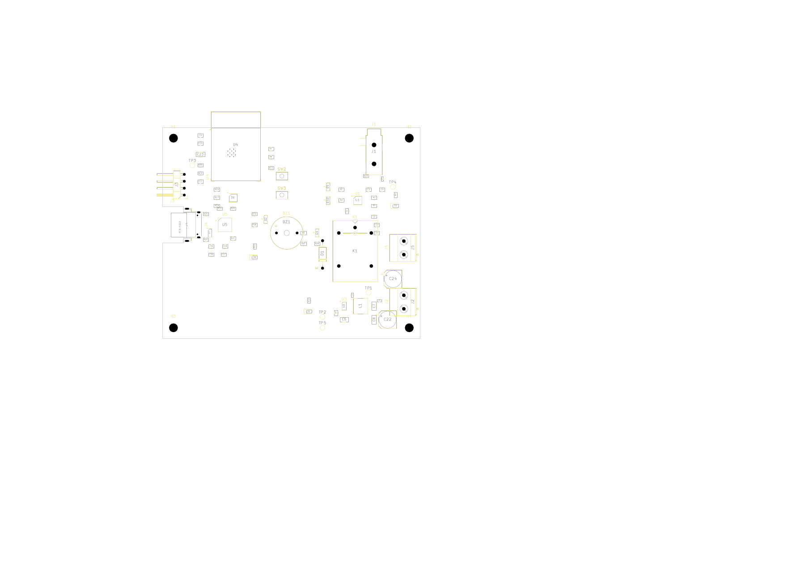
smart_db_v2/smart_db/work/placement.png
