c-lydia/SmartDB/smart_db_v2/smart_db/work/proposal_cover.png

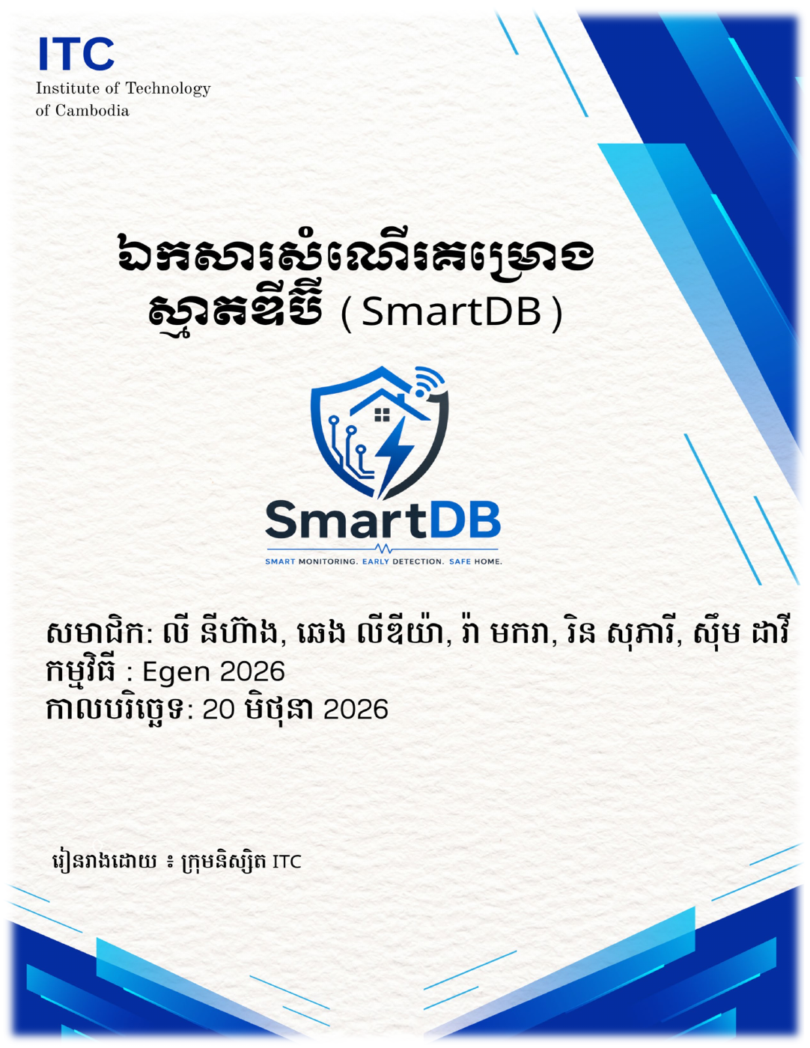
smart_db_v2/smart_db/work/proposal_cover.png
