c-lydia/SmartDB/smart_db_v2/smart_db/work/step_model_sources/BOM.txt

3DX_Same_Sky_Supplier: Same Sky
3DX_Same_Sky_Description: 3.5 mm, Stereo, Right Angle, Surface Mount (SMT), 3 Conductors, 0 Internal Switches, Audio Jack Connector
3DX_Same_Sky_Model Number: SJ-3523-SMT-TR
