c-lydia/SmartDB/smart_db_v2/smart_db/work/before_camera_power/smart_db.step

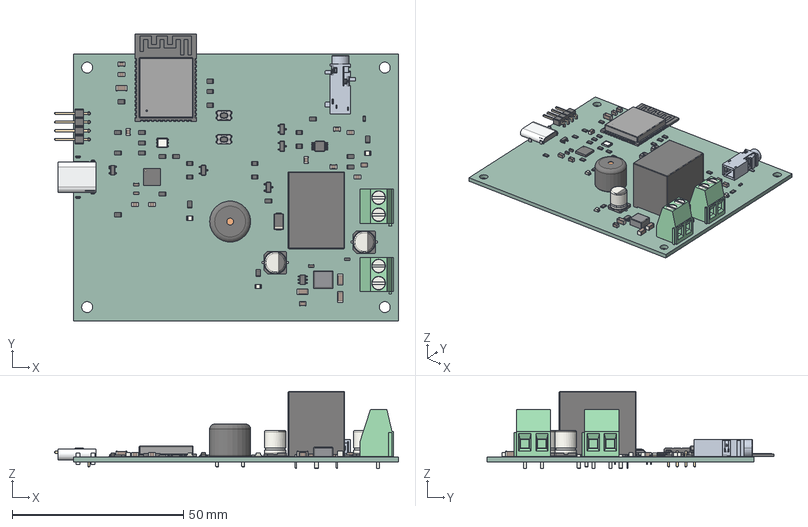
[picture p80: CAD file, 2026-10-10]
smart_db_v2/smart_db/work/before_camera_power/smart_db.step
100.5 x 83.8 x 22.6 mm
C_0805_2012Metric x 12
Simplified SMLVN6 body
Lens preview
Terminal x 6
Anode index
TerminalBlock_Phoenix_MKDS-1,5-2_1x02_P5.00mm_Horizontal x 2
R_0805_2012Metric x 26
TSSOP-10_3x3mm_P0.5mm
C_1206_3216Metric x 4
D_SMA
SW_Push_1P1T_NO_CK_KMR2 x 2
SOT-23 x 4
ESP32-S3-WROOM-1
CP_Elec_63x77 x 2
C_0603_1608Metric x 3
Simplified USB shell
Rear insulator
Tongue
Preview contact 0
Preview contact 1
Preview contact 2
Preview contact 3
Preview contact 4
Preview contact 5
Preview contact 6
Preview contact 7
Preview contact 8
Preview contact 9
Mount tab 0
Mount tab 1
Mount tab 2
Mount tab 3
TSOT-23-6
L_Bourns_SRP5030T
LED_0805_2012Metric x 3
R_0603_1608Metric
SOT-143
Fuse_0603_1608Metric
Relay_SPDT_Omron-G5LE-1
Buzzer_12x95RM76
QFN-28-1EP_5x5mm_Pitch0.5mm
PinHeader_1x04_P254mm_Horizontal
smart_db_PCB
