c-lydia/SmartDB/smart_db_v2/archive/bench_before_compact_2026-10-08/smart_db/smart_db.step

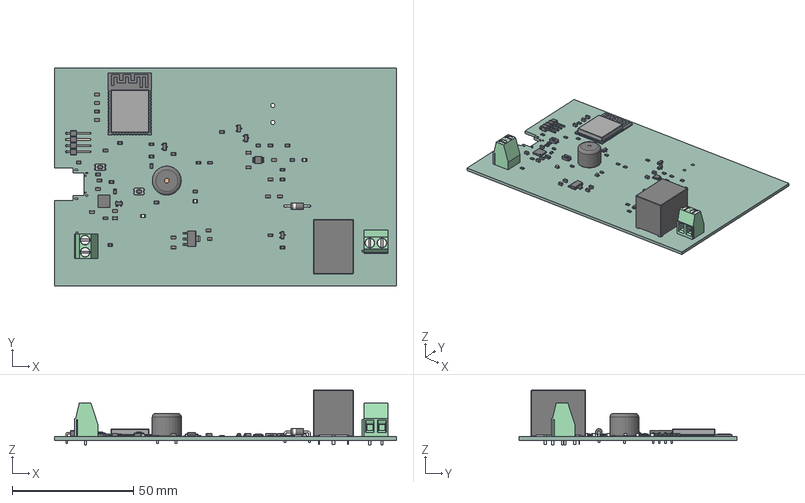
[picture p83: CAD file, 2026-10-10, an earlier design]
smart_db_v2/archive/bench_before_compact_2026-10-08/smart_db/smart_db.step
141.0 x 90.0 x 22.6 mm
R_0805_2012Metric x 25
C_0805_2012Metric x 17
TerminalBlock_Phoenix_MKDS-1,5-2_1x02_P5.00mm_Horizontal x 2
SOT-23 x 4
Fuse_0805_2012Metric x 2
PinHeader_1x04_P254mm_Horizontal
SW_Push_1P1T_NO_CK_KMR2 x 2
Buzzer_12x95RM76
LED_0805_2012Metric x 3
SOT-223
ESP32-S3-WROOM-1
TSSOP-10_3x3mm_P0.5mm
SOT-143
QFN-28-1EP_5x5mm_Pitch0.5mm
Relay_SPDT_Omron-G5LE-1
D_DO-41_SOD81_P10.16mm_Horizontal
smart_db-unsaved-export-i1mAHy_PCB
