c-lydia/SmartDB/smart_db_v2/smart_db/work/schematic.pdf

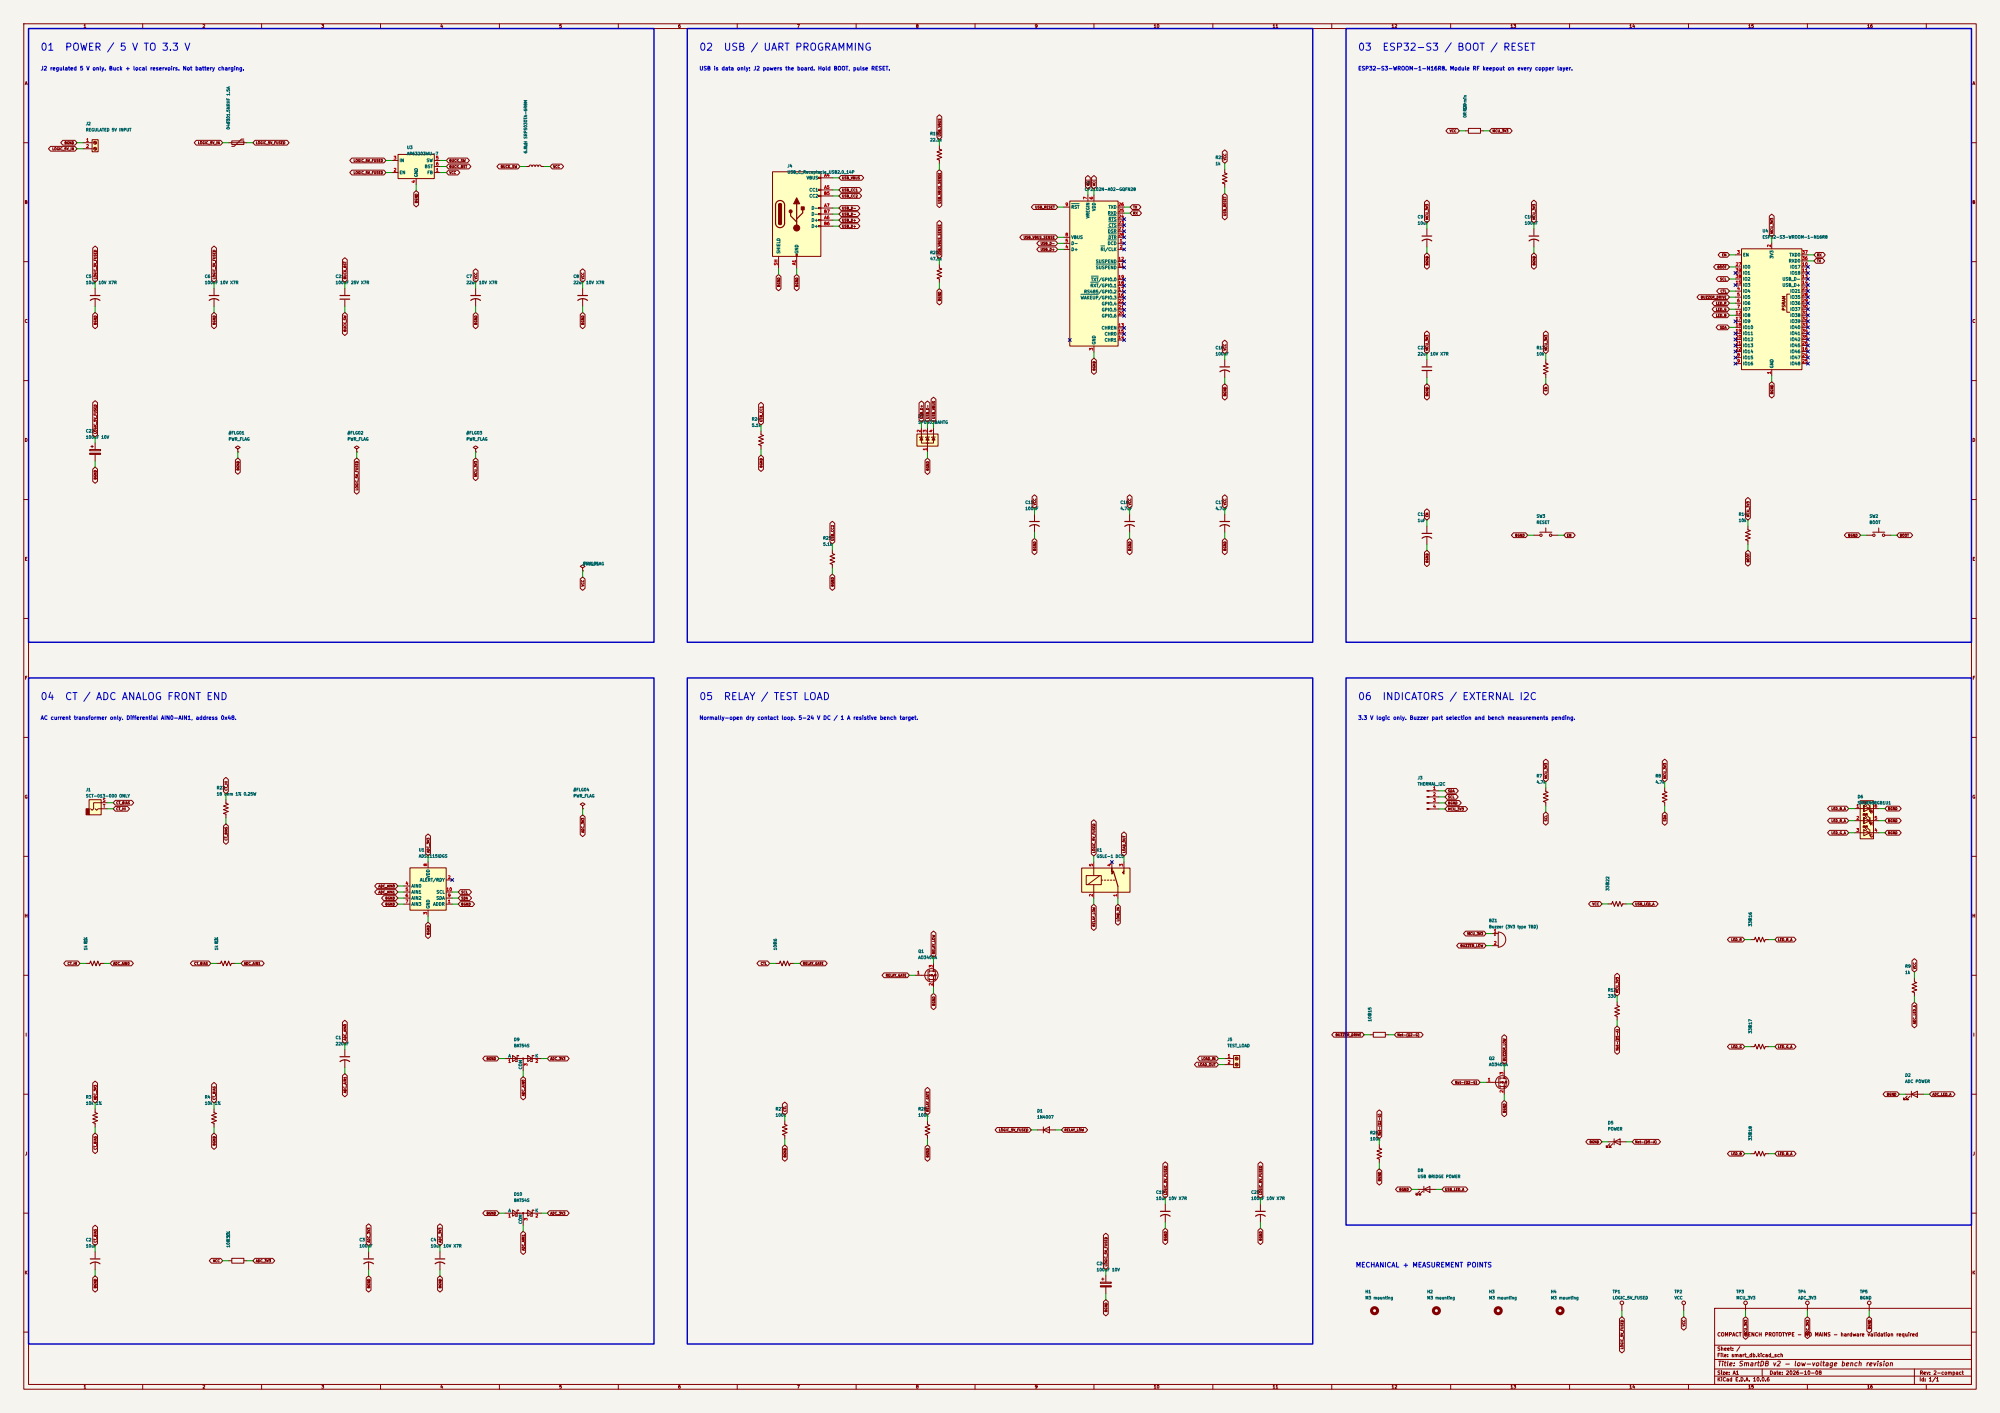
[picture p84: page 1]

J2 regulated 5 V only. Buck + local reservoirs. Not battery charging.

USB is data only; J2 powers the board. Hold BOOT, pulse RESET.

ESP32-S3-WROOM-1-N16R8. Module RF keepout on every copper layer.

FGH
04 CT / ADC ANALOG FRONT END

AC current transformer only. Differential AIN0-AIN1, address 0x48.

Normally-open dry contact loop. 5-24 V DC / 1 A resistive bench target.

3.3 V logic only. Buzzer part selection and bench measurements pending.

COMPACT BENCH PROTOTYPE - NO MAINS - hardware validation required

Sheet: /
File: smart_db.kicad_sch
Title: SmartDB v2 - low-voltage bench revision

Size: A1 | Rev: 2-compact
KiCad E.D.A. 10.0.6 | Id: 1/1
