c-lydia/SmartDB/smart_db_v2/smart_db/work/schematic_current.pdf

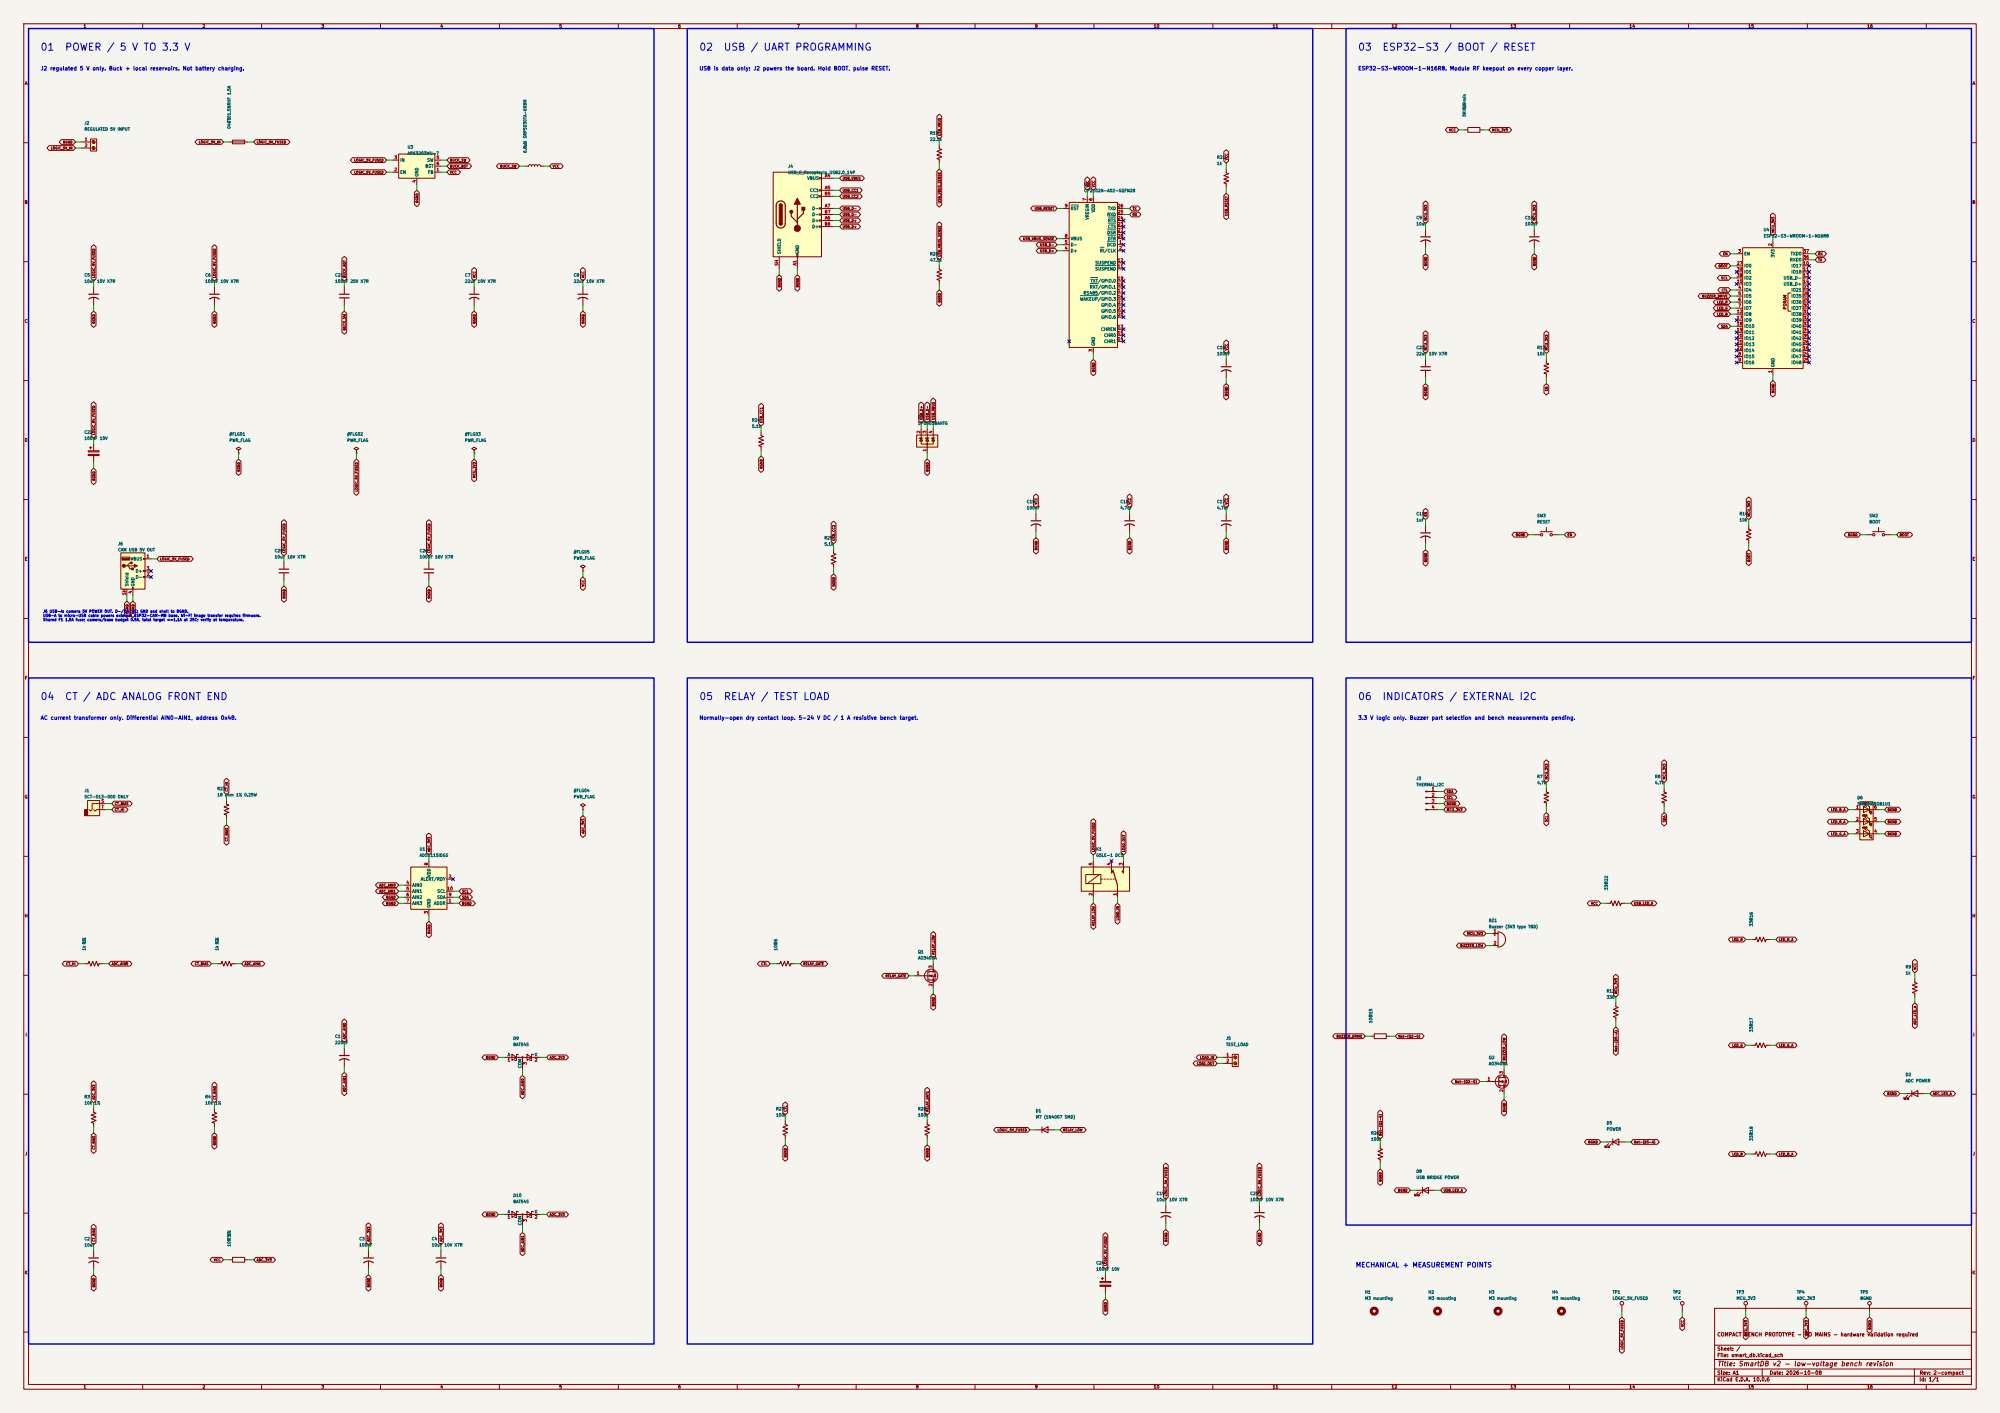
[picture p85: page 1]

J2 regulated 5 V only. Buck + local reservoirs. Not battery charging.

Normally-open dry contact loop. 5-24 V DC / 1 A resistive bench target.

COMPACT BENCH PROTOTYPE - NO MAINS - hardware validation required R1 1k 1%

Sheet: /
File: smart_db.kicad_sch
Title: SmartDB v2 - low-voltage bench revision

Size: A1 | Rev: 2-compact
KiCad E.D.A. 10.0.6 | Id: 1/1
