c-lydia/SmartDB/docs/doc_pdf/jetson_nano_config.pdf

## Jetson Orin Nano Configuration

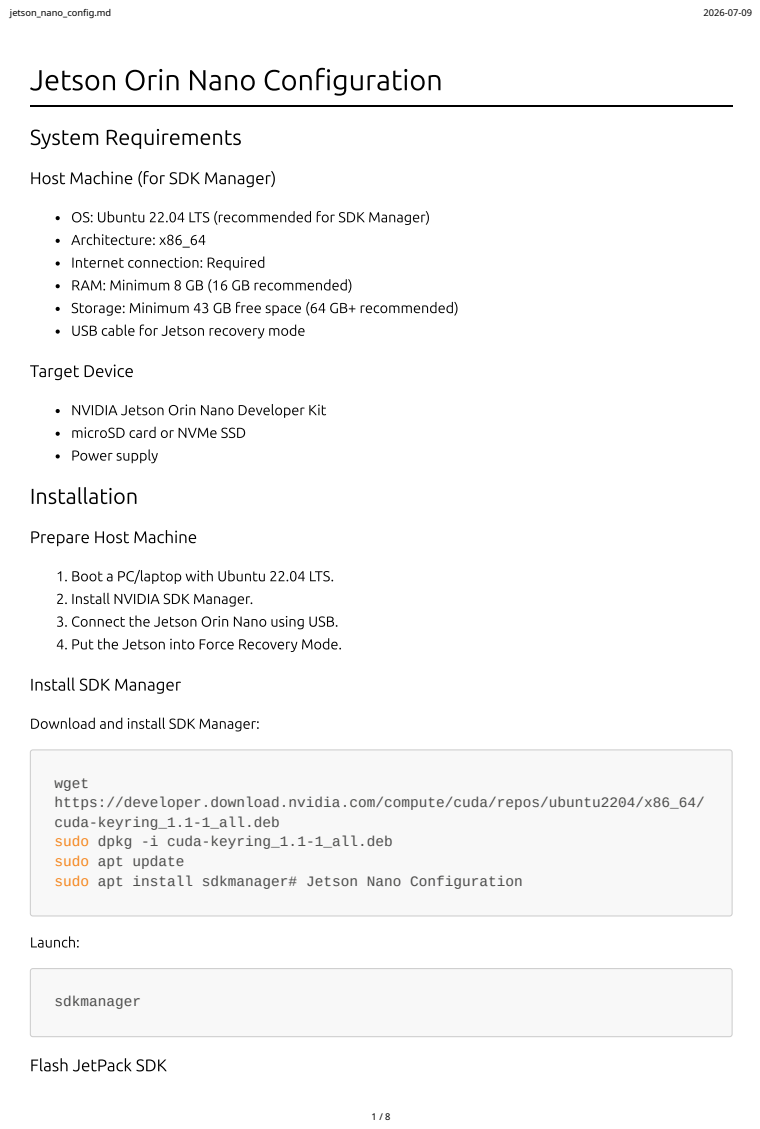
[picture p86: page 1]
System Requirements; Architecture: x86_64; Target Device; Power supply; Installation; Launch:; sdkmanager; jetson_nano_config.md

Host Machine (for SDK Manager)

OS: Ubuntu 22.04 LTS (recommended for SDK Manager)

Internet connection: Required

RAM: Minimum 8 GB (16 GB recommended)

Storage: Minimum 43 GB free space (64 GB+ recommended)

USB cable for Jetson recovery mode

NVIDIA Jetson Orin Nano Developer Kit

microSD card or NVMe SSD

Prepare Host Machine

1. Boot a PC/laptop with Ubuntu 22.04 LTS.

2. Install NVIDIA SDK Manager.

3. Connect the Jetson Orin Nano using USB.

4. Put the Jetson into Force Recovery Mode.

Install SDK Manager

Download and install SDK Manager:

wget
https://developer.download.nvidia.com/compute/cuda/repos/ubuntu2204/x86_64/
cuda-keyring_1.1-1_all.deb
sudo dpkg -i cuda-keyring_1.1-1_all.deb
sudo apt update
sudo apt install sdkmanager# Jetson Nano Configuration

Flash JetPack SDK

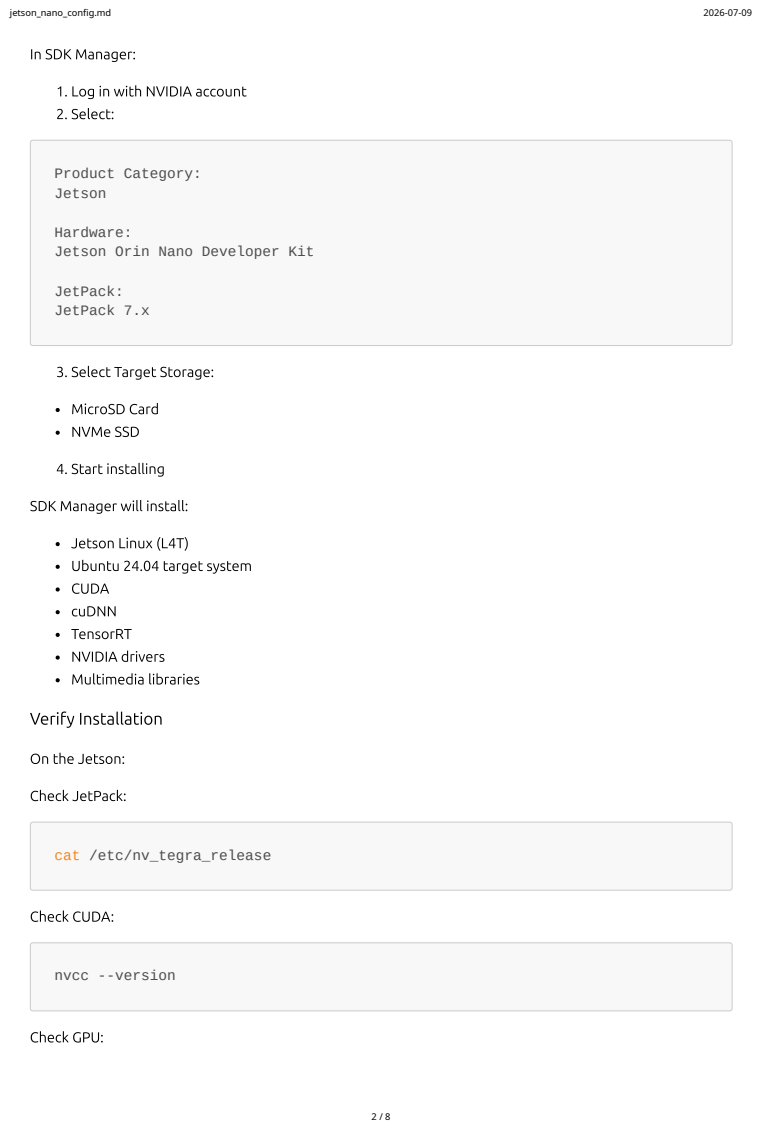
[picture p87: page 2]
2. Select:; Product Category: Jetson; JetPack: JetPack 7.x; MicroSD Card; NVMe SSD; 4. Start installing; Jetson Linux (L4T); CUDA; cuDNN; TensorRT; NVIDIA drivers; Multimedia libraries; Verify Installation; Check JetPack:; cat /etc/nv_tegra_release; Check CUDA:; nvcc --version; Check GPU:

In SDK Manager:

1. Log in with NVIDIA account

Hardware:
Jetson Orin Nano Developer Kit

3. Select Target Storage:

SDK Manager will install:

Ubuntu 24.04 target system

On the Jetson:

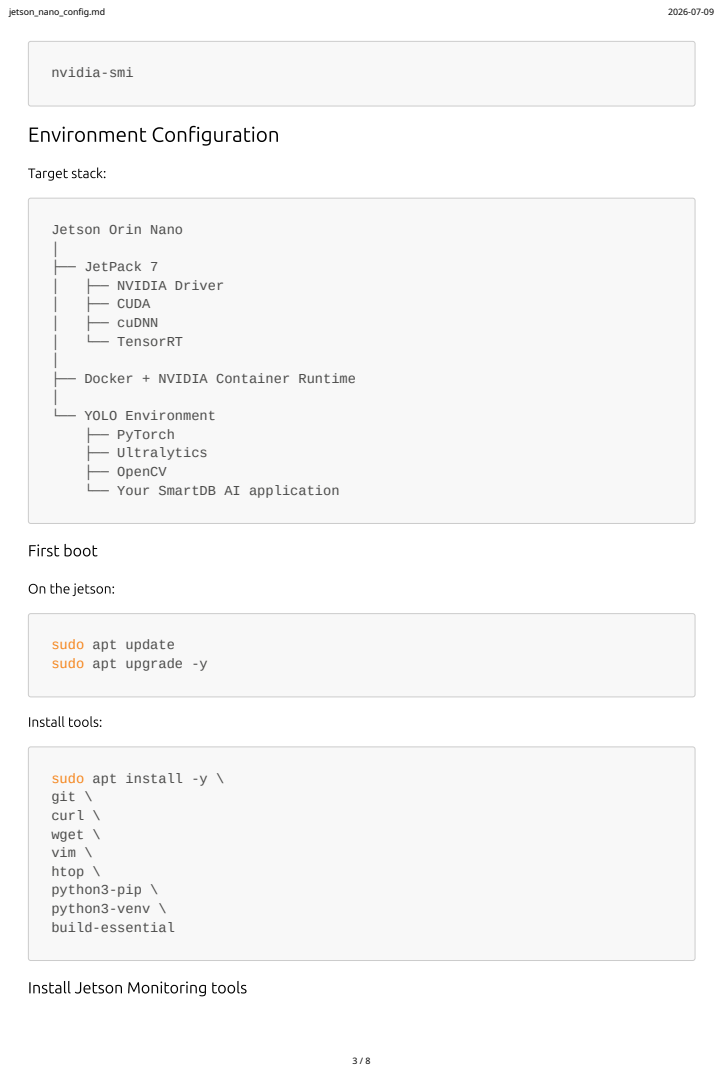
[picture p88: page 3]
nvidia-smi; Environment Configuration; Target stack:; ├── NVIDIA Driver; ├── CUDA; ├── cuDNN; └── TensorRT; First boot; Install tools:; sudo apt install -y \ git \ curl \ wget \ vim \ htop \ python3-pip \ python3-venv \ build-essential

Jetson Orin Nano
├── JetPack 7
├── Docker + NVIDIA Container Runtime
└── YOLO Environment
├── PyTorch
├── Ultralytics
├── OpenCV
└── Your SmartDB AI application

On the jetson:

sudo apt update
sudo apt upgrade -y

Install Jetson Monitoring tools

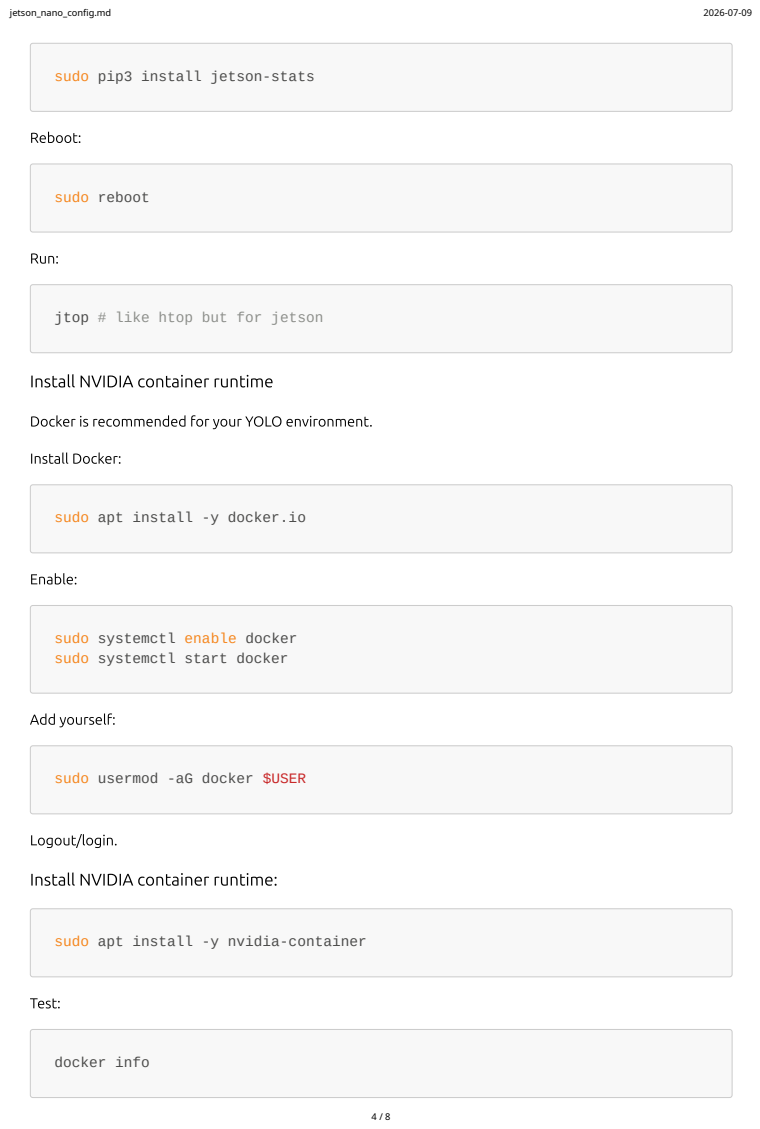
[picture p89: page 4]
Reboot:; sudo reboot; Run:; Install Docker:; Enable:; Add yourself:; Logout/login.; Test:; docker info

sudo pip3 install jetson-stats

jtop # like htop but for jetson

Install NVIDIA container runtime

Docker is recommended for your YOLO environment.

sudo apt install -y docker.io

sudo systemctl enable docker
sudo systemctl start docker

sudo usermod -aG docker $USER

Install NVIDIA container runtime:

sudo apt install -y nvidia-container

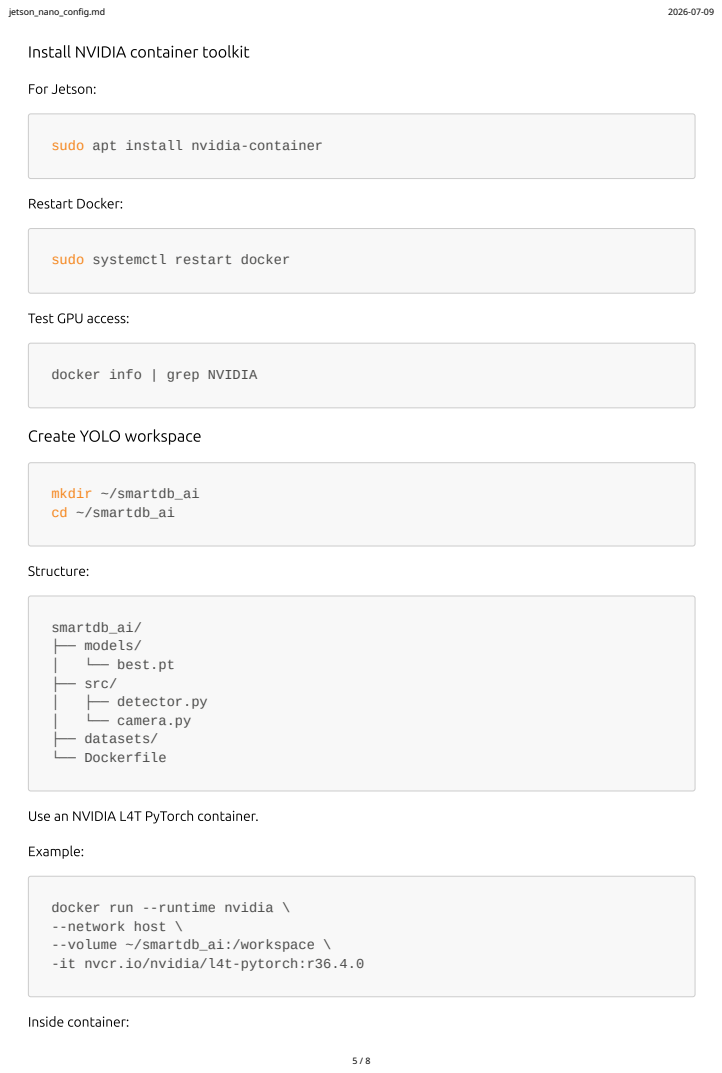
[picture p90: page 5]
For Jetson:; Restart Docker:; mkdir ~/smartdb_ai cd ~/smartdb_ai; Structure:; smartdb_ai/ ├── models/; └── best.pt; ├── src/; ├── detector.py; └── camera.py; ├── datasets/ └── Dockerfile; Example:; Inside container:

Install NVIDIA container toolkit

sudo apt install nvidia-container

sudo systemctl restart docker

Test GPU access:

docker info | grep NVIDIA

Create YOLO workspace

Use an NVIDIA L4T PyTorch container.

docker run --runtime nvidia \
--network host \
--volume ~/smartdb_ai:/workspace \
-it nvcr.io/nvidia/l4t-pytorch:r36.4.0

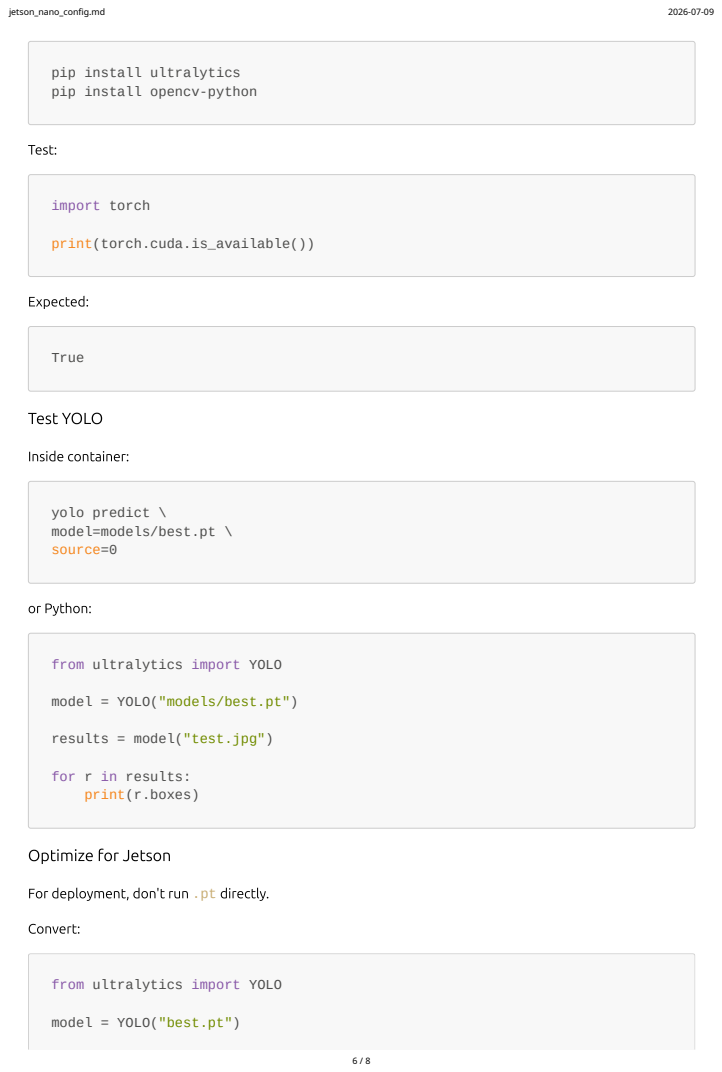
[picture p91: page 6]
Test:; import torch; Expected:; True; Test YOLO; Inside container:; or Python:; Convert:

pip install ultralytics
pip install opencv-python

print(torch.cuda.is_available())

yolo predict \
model=models/best.pt \
source=0

from ultralytics import YOLO

model = YOLO("models/best.pt")

results = model("test.jpg")

for r in results:
print(r.boxes)

Optimize for Jetson

For deployment, don't run .pt directly.

model = YOLO("best.pt")

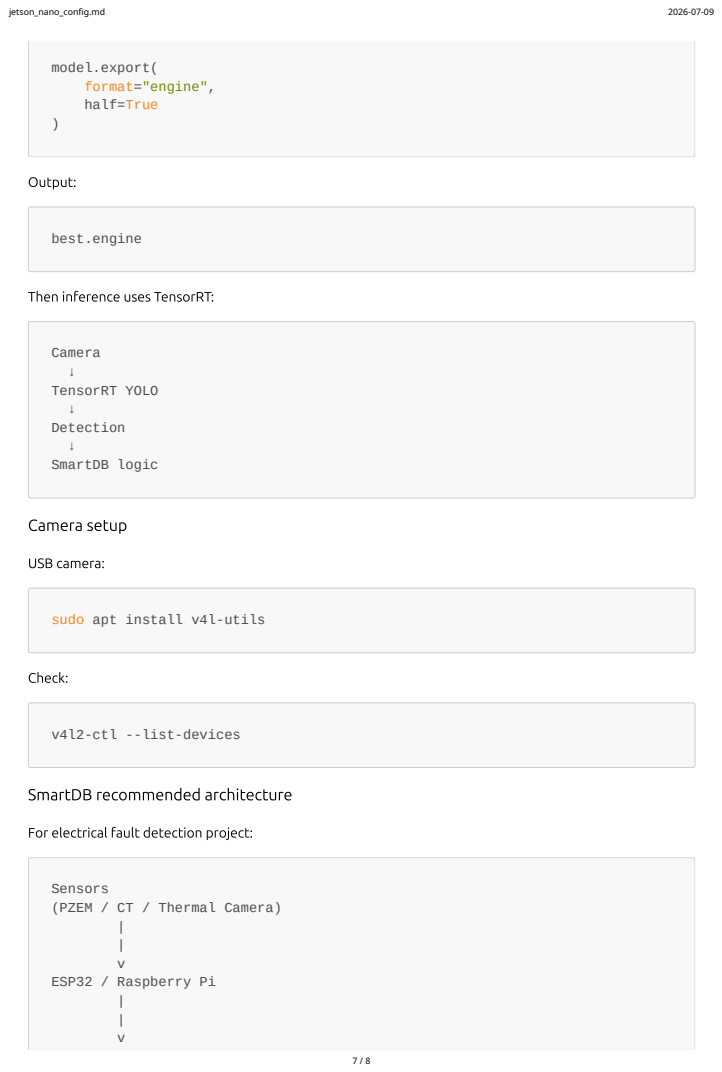
[picture p92: page 7]
model.export( format="engine", half=True; Output:; best.engine; Camera ↓ TensorRT YOLO ↓ Detection ↓ SmartDB logic; Camera setup; USB camera:; Check:; | | v ESP32 / Raspberry Pi | | v

Then inference uses TensorRT:

sudo apt install v4l-utils

v4l2-ctl --list-devices

SmartDB recommended architecture

For electrical fault detection project:

Sensors
(PZEM / CT / Thermal Camera)

Jetson Orin Nano
├── YOLO
│ └── Fire/smoke/object detection │
├── TensorRT
│
└── Alert System
| | ├── Database └── Dashboard

8 / 8
