c-lydia/SmartDB/smart_db_v2/smart_db/work/back_labels_current.pdf

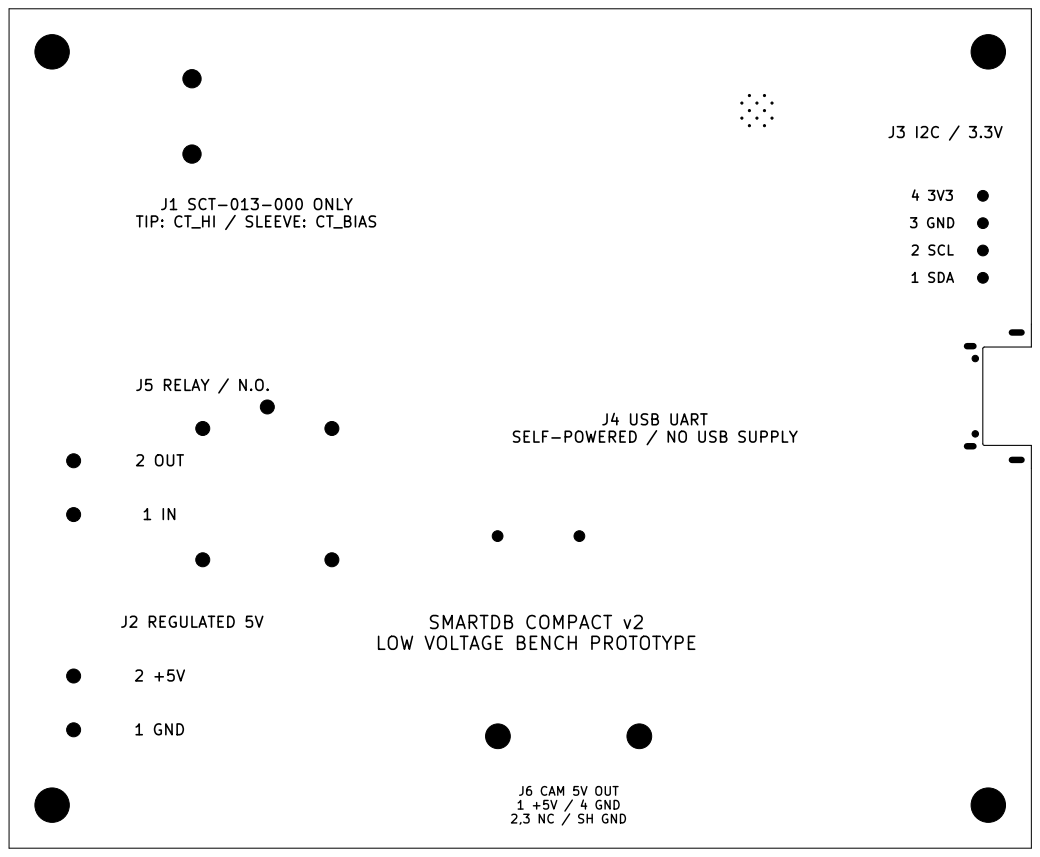
[picture p93: page 1]

J5 RELAY / N.O. J2 REGULATED 5V 2 OUT 1 IN

J4 USB UART SELF-POWERED / NO USB SUPPLY

LOW VOLTAGE BENCH PROTOTYPE
