c-lydia/SmartDB/smart_db_v2/smart_db/work/placement_current.pdf

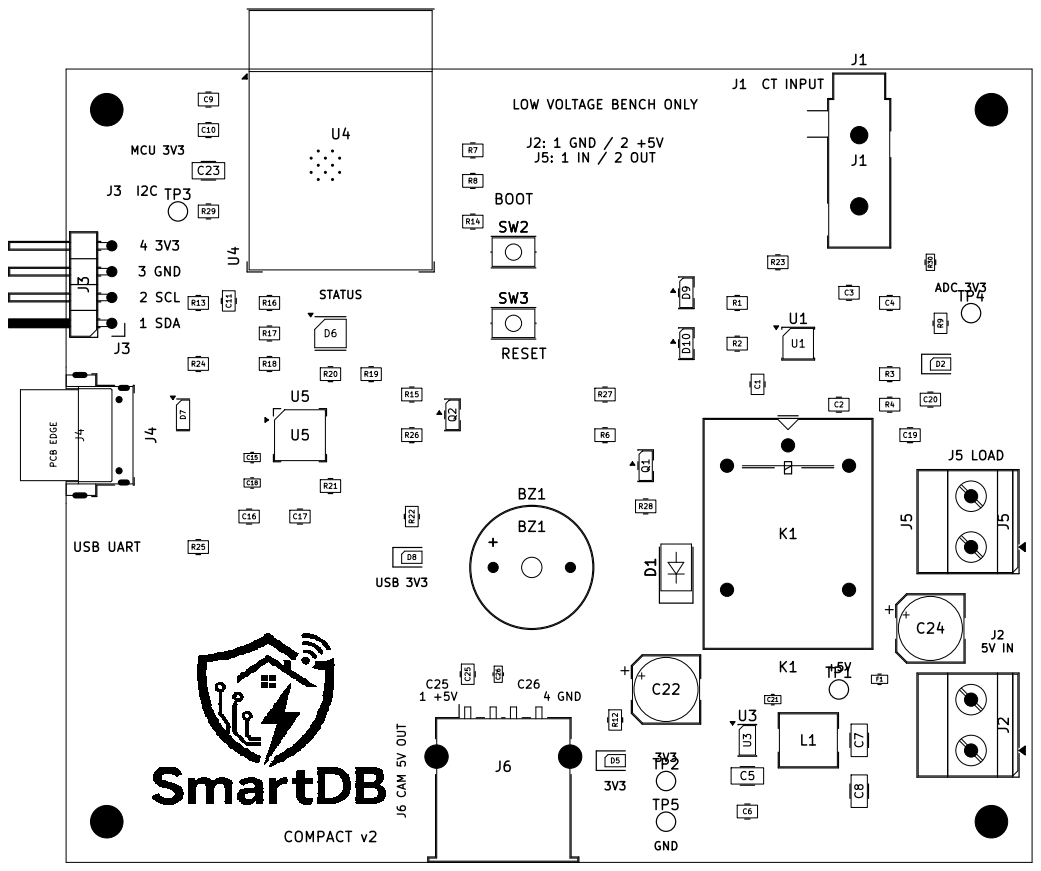
[picture p94: page 1]

J5: 1 IN / 2 OUT LOW VOLTAGE BENCH ONLY
