c-lydia/SmartDB/smart_db_v2/smart_db_schem_v2.pdf

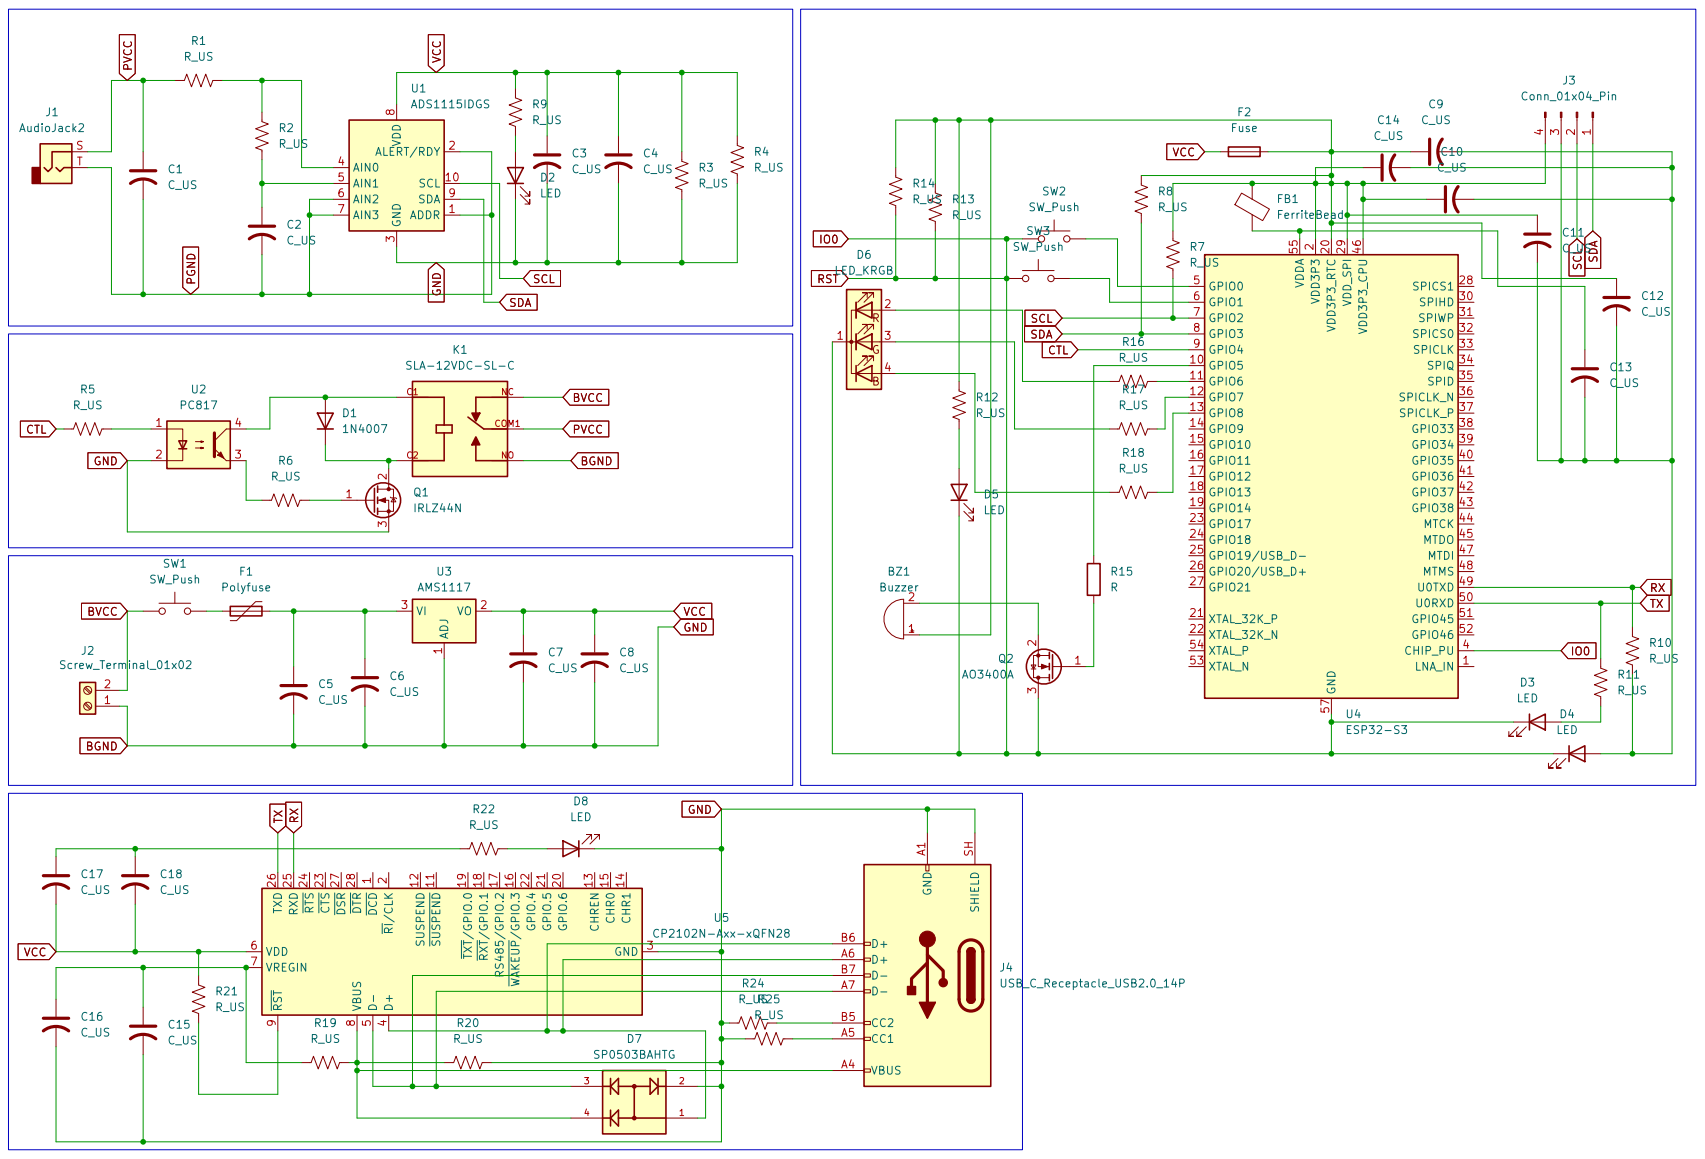
[picture p95: page 1]
