c-lydia/SmartDB/smart_db_v2/smart_db/work/placement.pdf

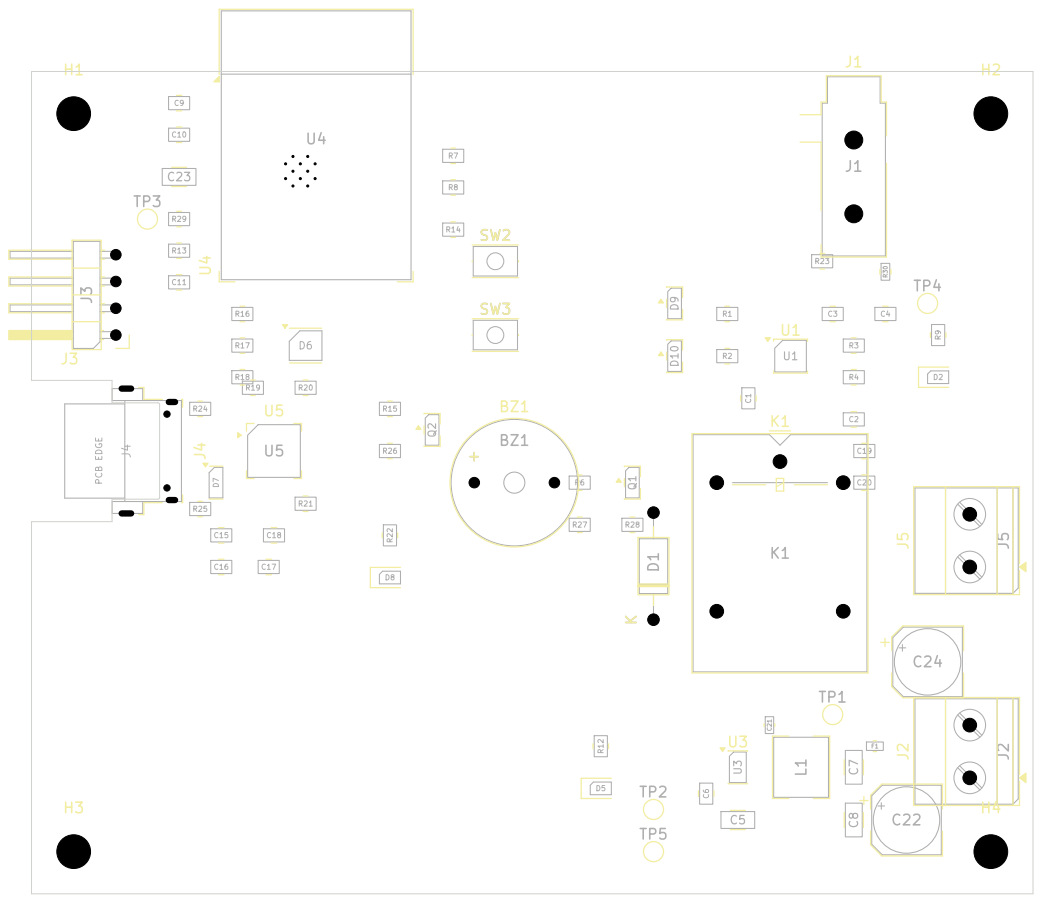
[picture p96: page 1]
