c-lydia/SmartDB/smart_db_v2/smart_db/work/routing_current.pdf

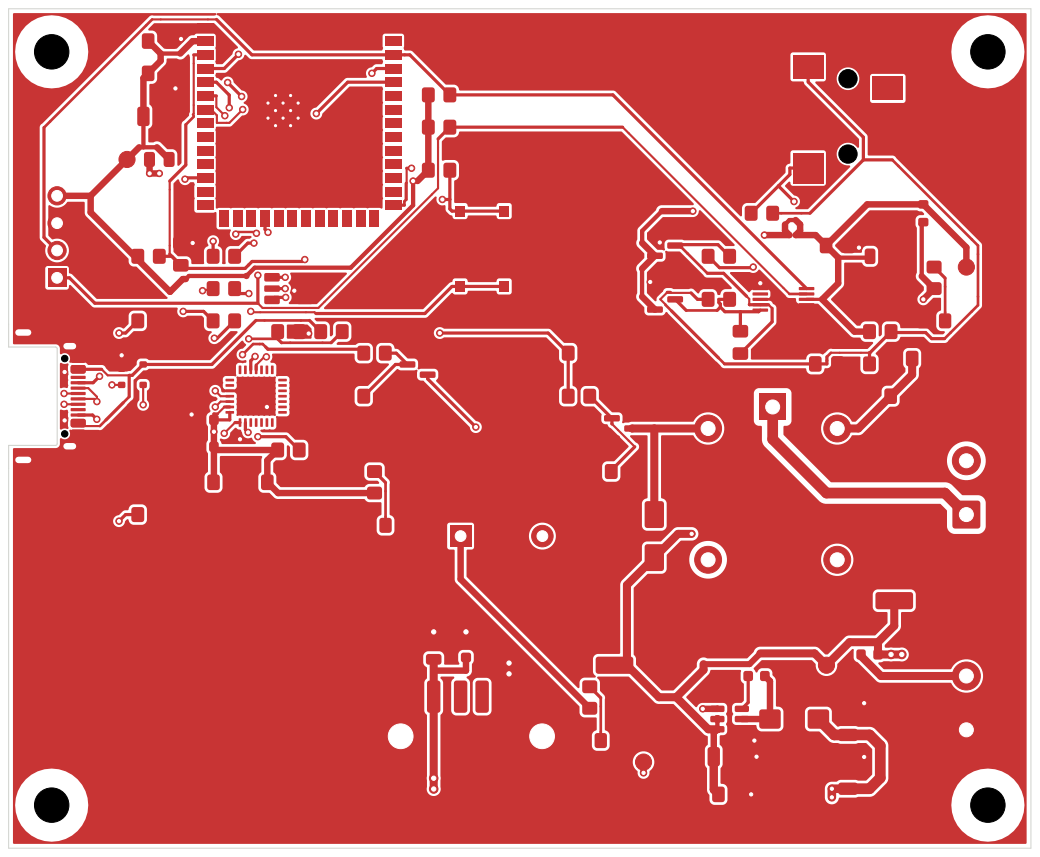
[picture p97: page 1]

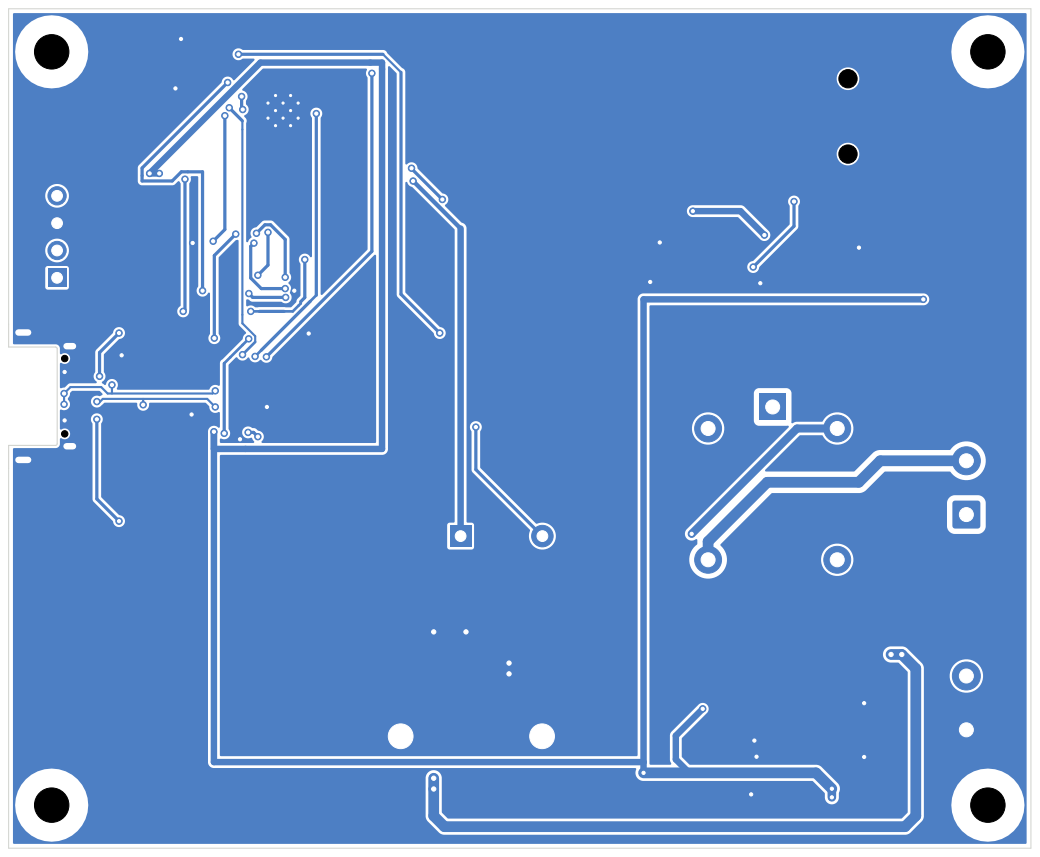
[picture p98: page 2]

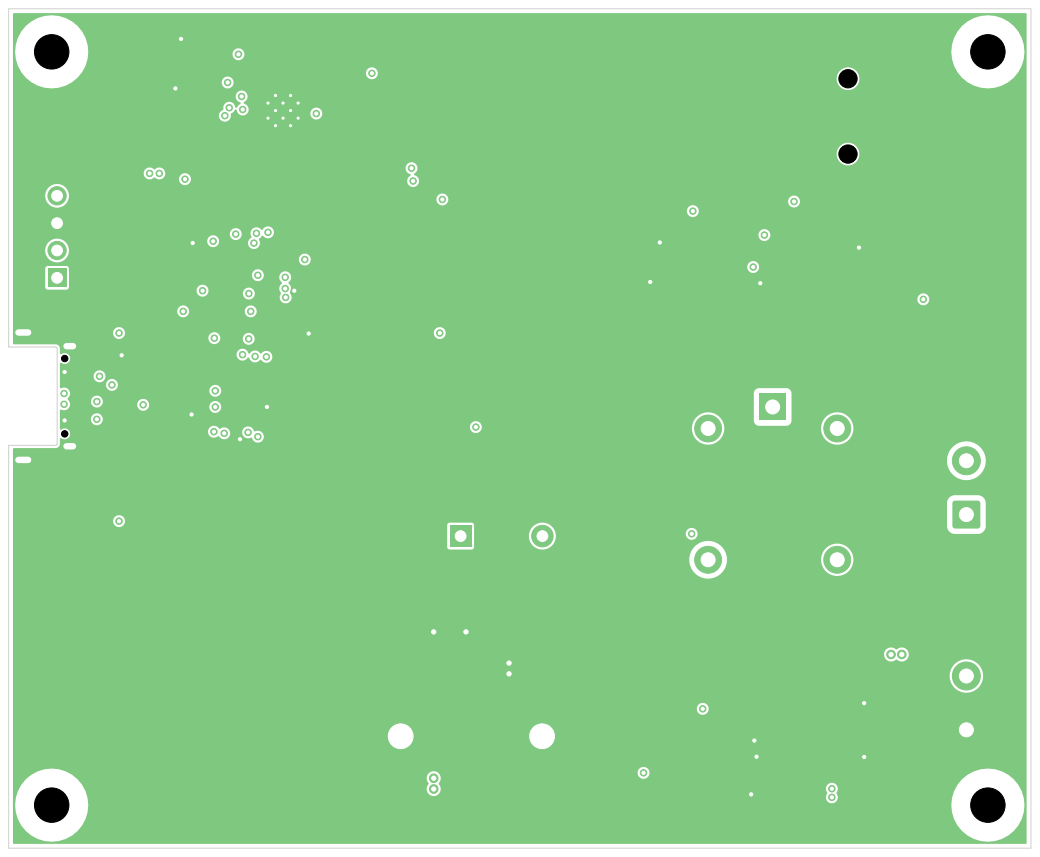
[picture p99: page 3]

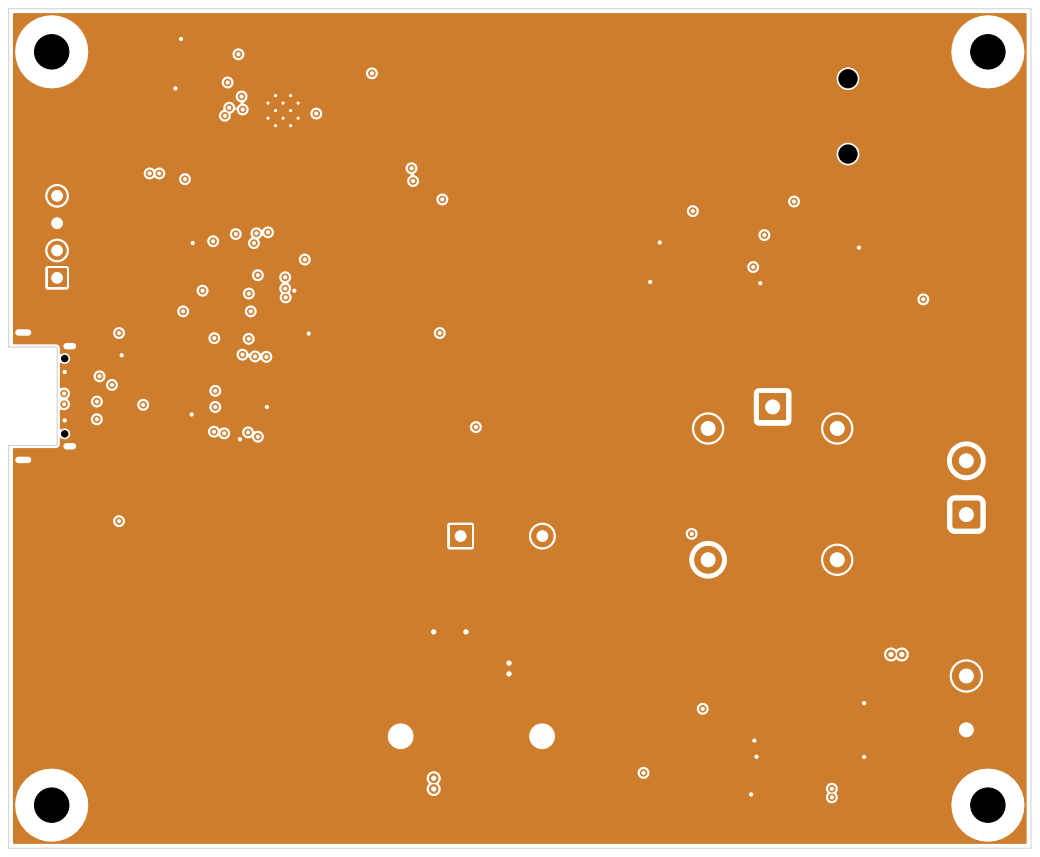
[picture p100: page 4]
