c-lydia/SmartDB/smart_db_v2/archive/bench_before_compact_2026-10-08/smart_db_schem_v2.pdf

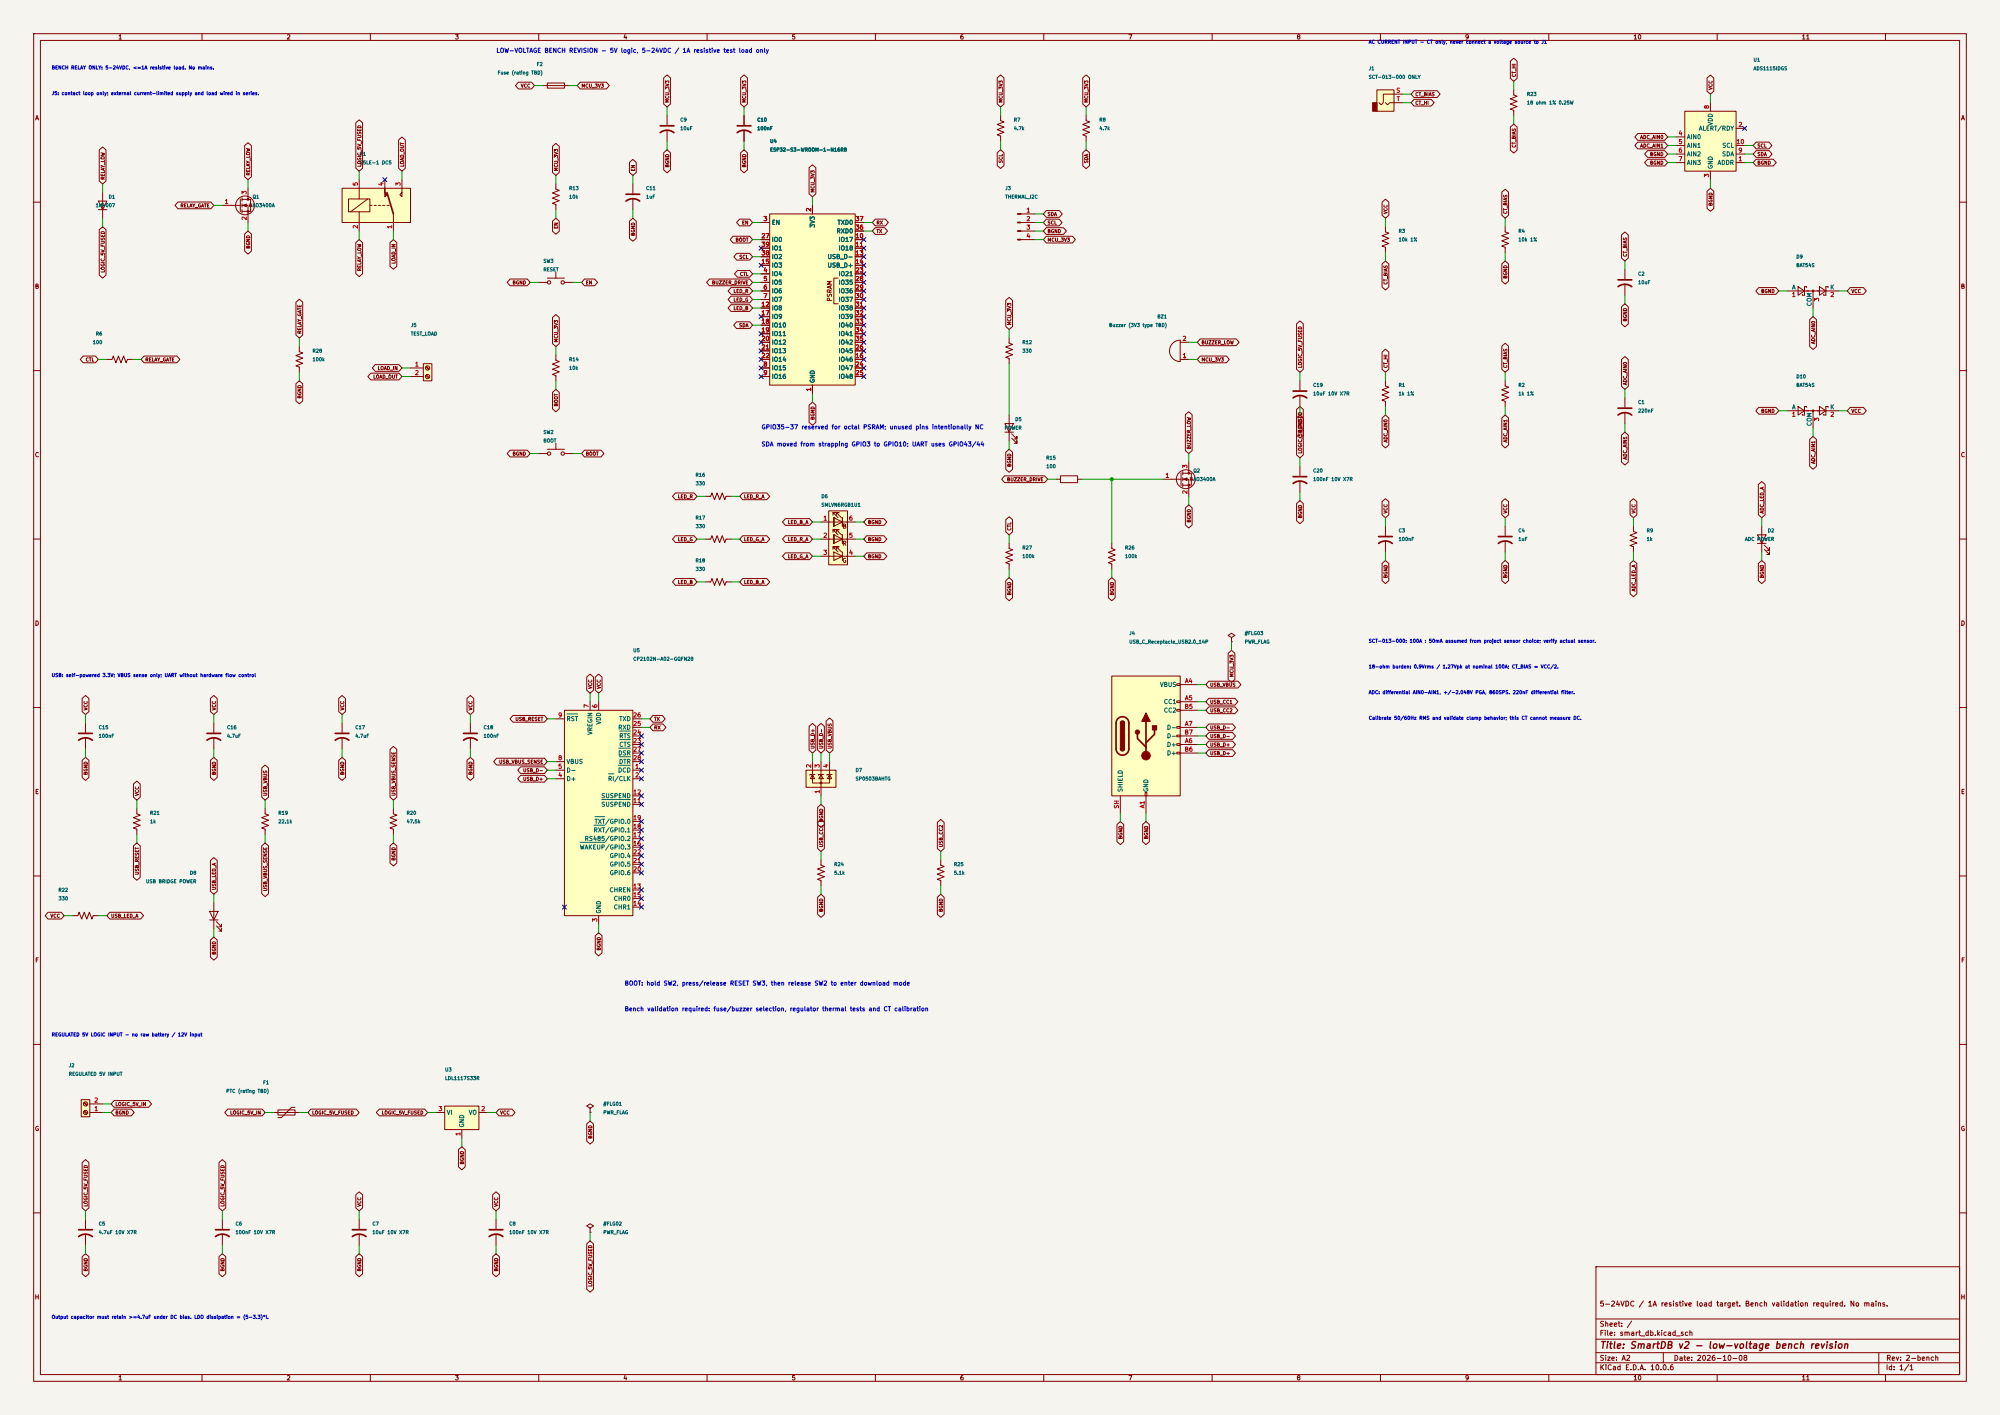
[picture p101: page 1]

AC CURRENT INPUT - CT only, never connect a voltage source to J1

LOW-VOLTAGE BENCH REVISION - 5V logic, 5-24VDC / 1A resistive test load only

BENCH RELAY ONLY: 5-24VDC, <=1A resistive load. No mains. J5: contact loop only; external current-limited supply and load wired in series.

ADC: differential AIN0-AIN1, +/-2.048V PGA, 860SPS. 220nF differential filter. GPIO35-37 reserved for octal PSRAM; unused pins intentionally NC

SCT-013-000: 100A : 50mA assumed from project sensor choice; verify actual sensor.

U5CP2102N-A02-GQFN28
SUSPEND 11 SUSPEND 12 CHREN 13 CHR1 14 CHR0 15 WAKEUP/GPIO.3 16 RS485/GPIO.2 17 RXT/GPIO.1 18 TXT/GPIO.0 19 GPIO.6 20 GPIO.5 21 GPIO.4 22 CTS 23 RTS 24 RXD 25 TXD 26 DSR 27 DTR 28

18-ohm burden: 0.9Vrms / 1.27Vpk at nominal 100A; CT_BIAS = VCC/2.

USB: self-powered 3.3V; VBUS sense only; UART without hardware flow control

Calibrate 50/60Hz RMS and validate clamp behavior; this CT cannot measure DC. Bench validation required: fuse/buzzer selection, regulator thermal tests and CT calibration

BOOT: hold SW2, press/release RESET SW3, then release SW2 to enter download mode

REGULATED 5V LOGIC INPUT - no raw battery / 12V input

5-24VDC / 1A resistive load target. Bench validation required. No mains.

Output capacitor must retain >=4.7uF under DC bias. LDO dissipation = (5-3.3)*I.

Sheet: /
File: smart_db.kicad_sch
Title: SmartDB v2 - low-voltage bench revision

Size: A2 | Rev: 2-bench
KiCad E.D.A. 10.0.6 | Id: 1/1
