c-lydia/SmartDB/smart_db_v2/archive/bench_before_compact_2026-10-08/review/bench_layout.pdf

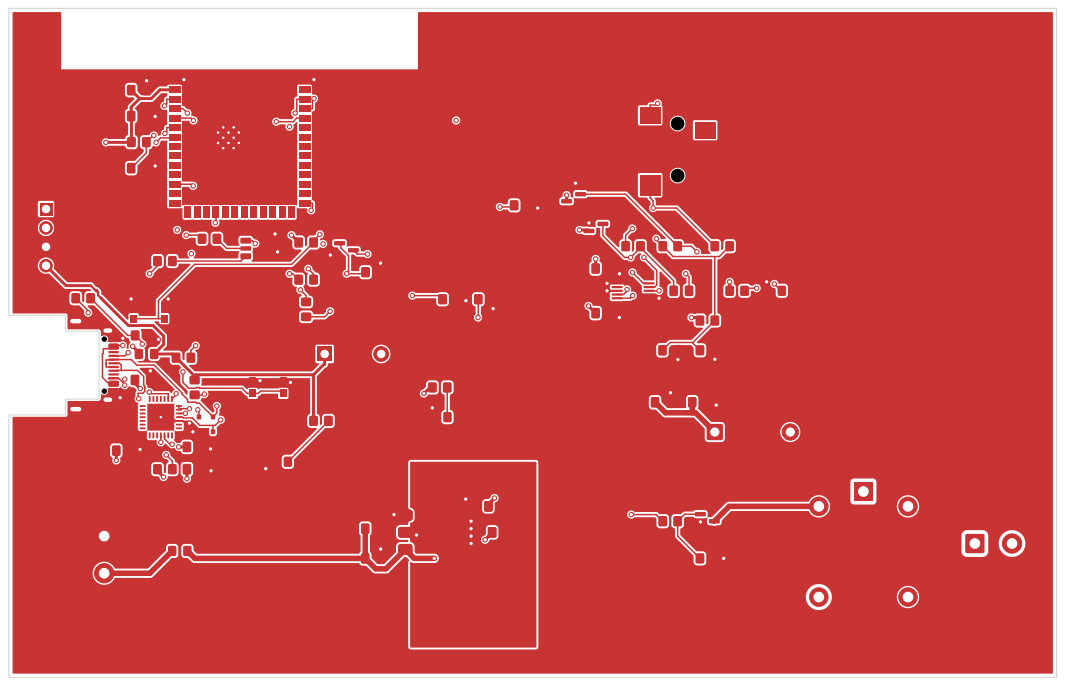
[picture p102: page 1]

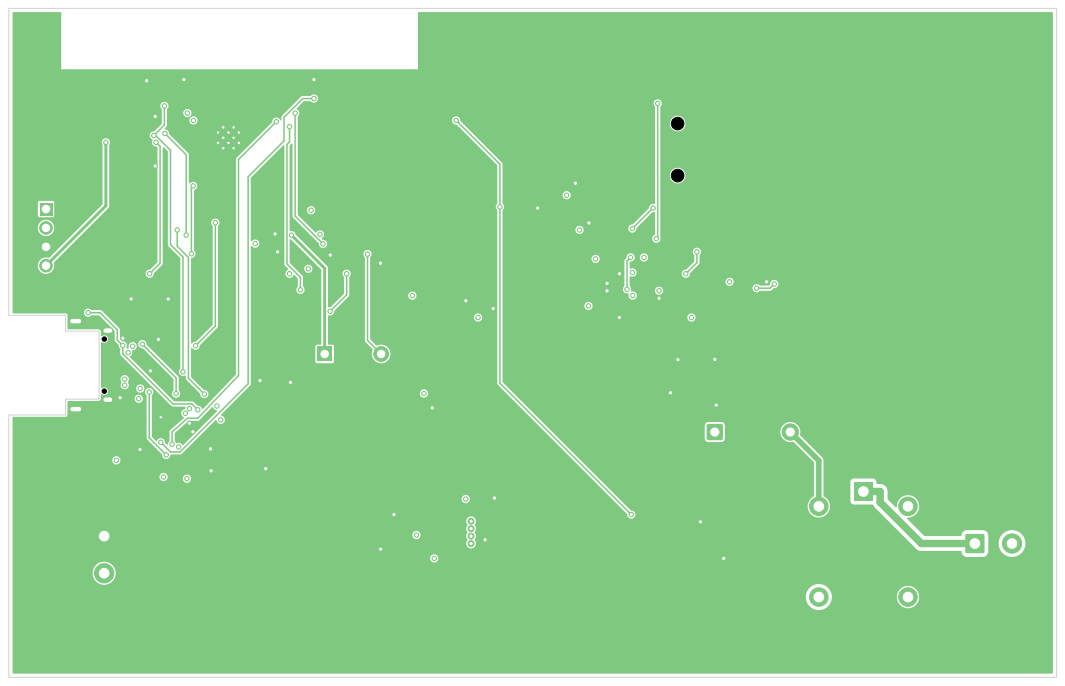
[picture p103: page 2]

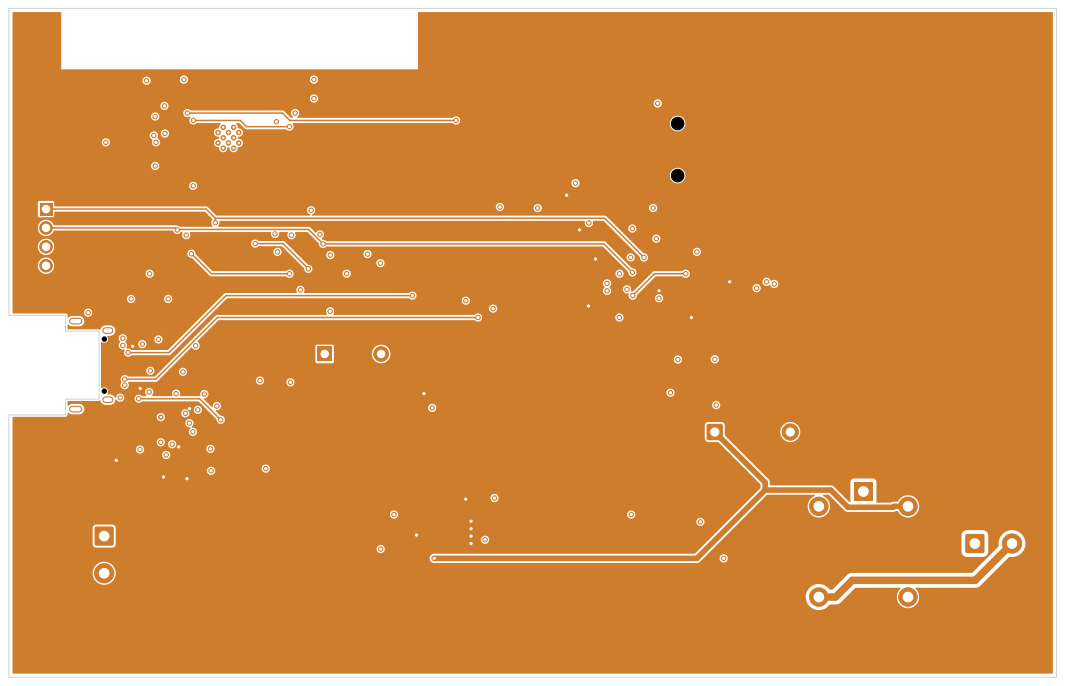
[picture p104: page 3]

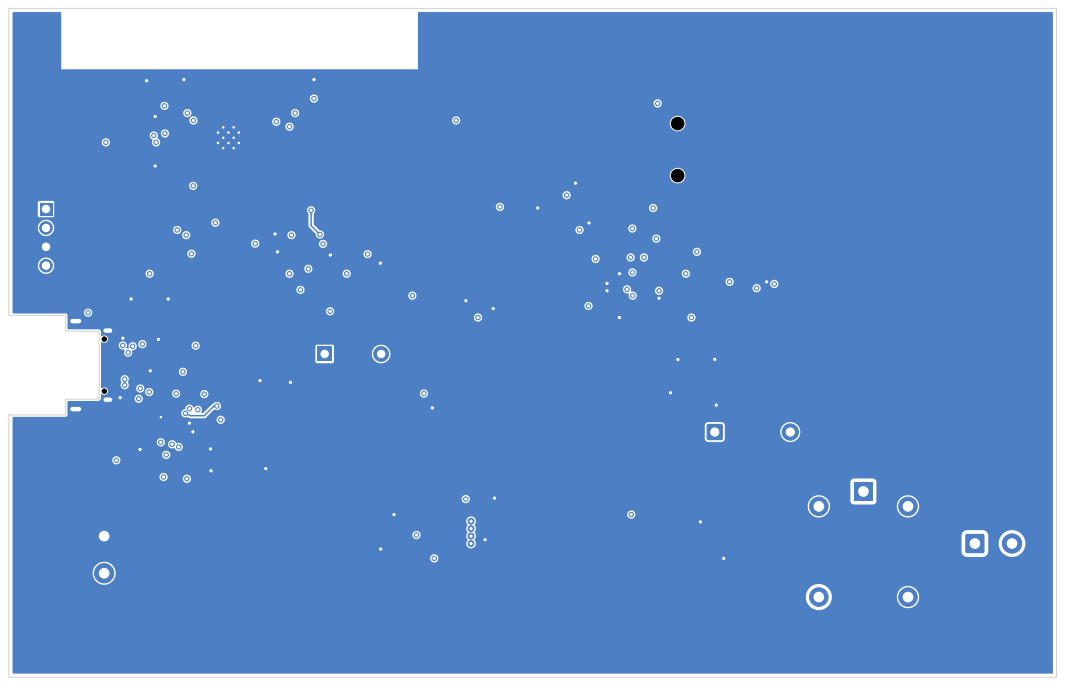
[picture p105: page 4]

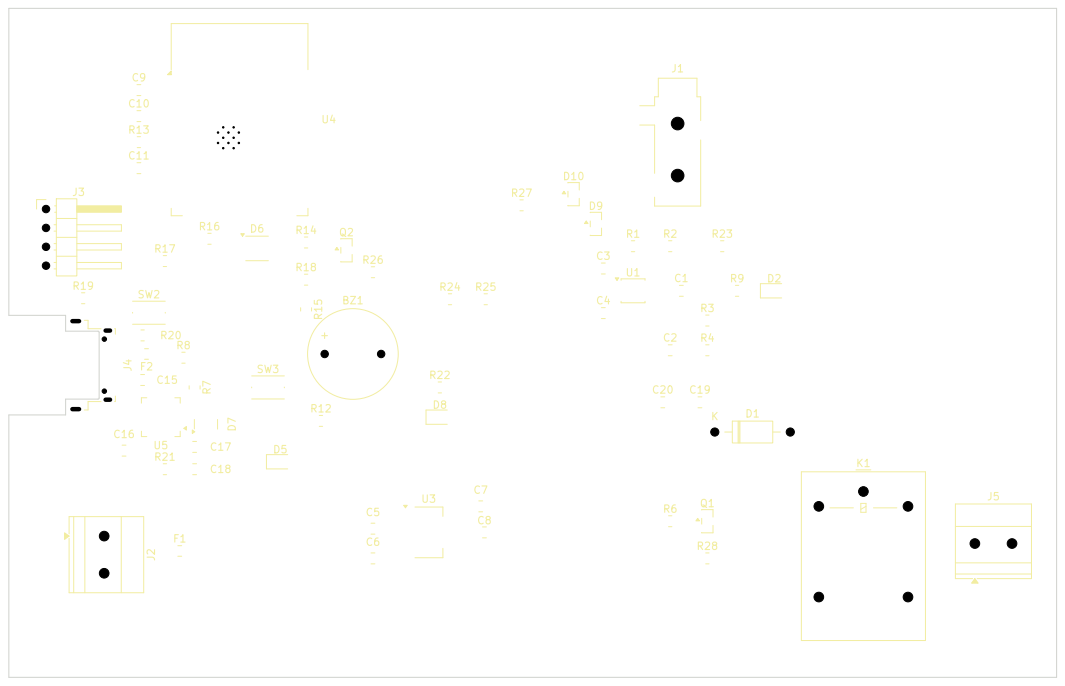
[picture p106: page 5]
