c-lydia/SmartDB/smart_db_v2/archive/bench_before_compact_2026-10-08/review/module_layout.pdf

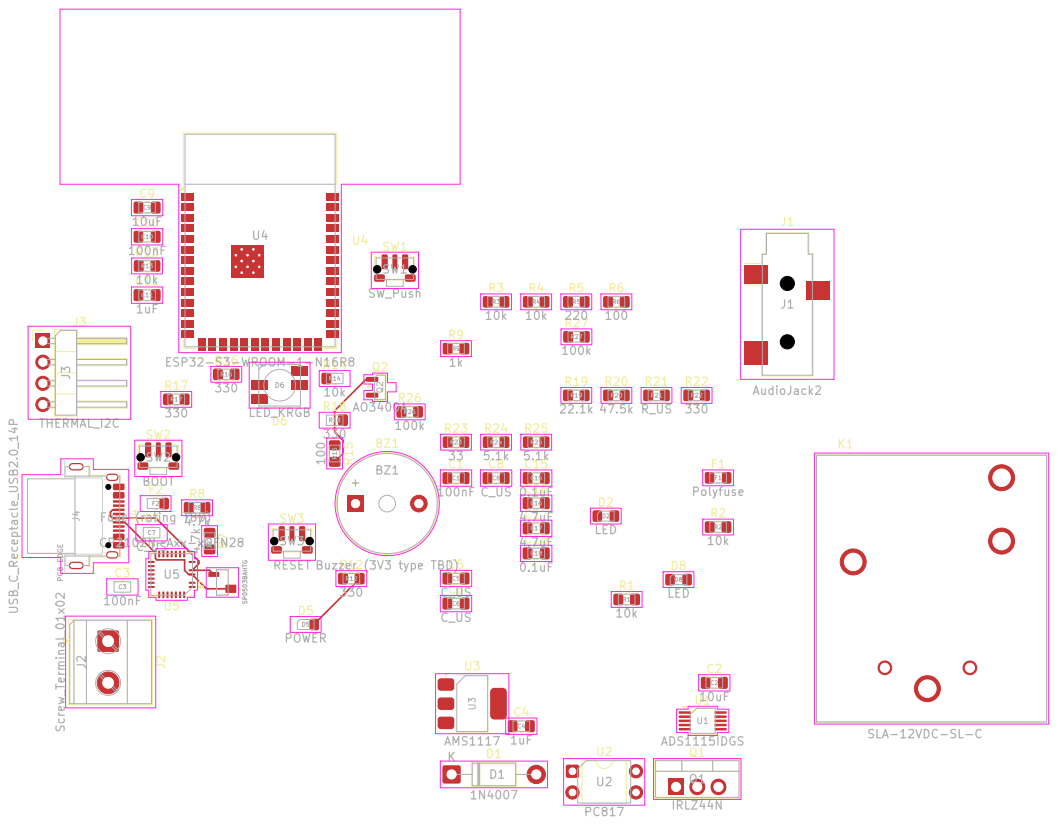
[picture p107: page 1]
