c-lydia/SmartDB/(list of files, drawings)

Other design files:
smart_db_v2/smart_db/work/connectors.dsn
smart_db_v2/smart_db/work/connectors_source.dsn
smart_db_v2/smart_db/work/finish.dsn
smart_db_v2/smart_db/work/finish_source.dsn
smart_db_v2/smart_db/work/remaining.dsn
smart_db_v2/smart_db/work/remaining_source.dsn
