c-lydia/SmartDB/smart_db_v2/smart_db/work/full_routing_backup/smart_db.kicad_pcb

## KiCad design smart_db_v2/smart_db/work/full_routing_backup/smart_db.kicad_pcb (2026-10-10)

Schematic: smart_db.kicad_sch, SmartDB v2 - low-voltage bench revision

Parts:
BZ1: Buzzer (3V3 type TBD); Buzzer_12x9.5RM7.6
C1: 220nF; C_0805_2012Metric_Pad1.18x1.45mm_HandSolder
C2, C9: 10uF; C_0805_2012Metric_Pad1.18x1.45mm_HandSolder
C3, C10: 100nF; C_0805_2012Metric_Pad1.18x1.45mm_HandSolder
C4: 10uF 10V X7R; C_0805_2012Metric
C5: 10uF 10V X7R; C_1206_3216Metric
C6, C20: 100nF 10V X7R; C_0805_2012Metric_Pad1.18x1.45mm_HandSolder
C7, C8, C23: 22uF 10V X7R; C_1206_3216Metric
C11: 1uF; C_0805_2012Metric_Pad1.18x1.45mm_HandSolder
C15, C18: 100nF; C_0603_1608Metric
C16, C17: 4.7uF; C_0805_2012Metric_Pad1.18x1.45mm_HandSolder
C19: 10uF 10V X7R; C_0805_2012Metric_Pad1.18x1.45mm_HandSolder
C21: 100nF 25V X7R; C_0603_1608Metric
C22, C24: 100uF 10V; CP_Elec_6.3x7.7
D1: M7 (1N4007 SMD); D_SMA
D2: ADC POWER; LED_0805_2012Metric_Pad1.15x1.40mm_HandSolder
D5: POWER; LED_0805_2012Metric_Pad1.15x1.40mm_HandSolder
D6: SMLVN6RGB1U1; LED_ROHM_SMLVN6
D7: SP0503BAHTG; SOT-143
D8: USB BRIDGE POWER; LED_0805_2012Metric_Pad1.15x1.40mm_HandSolder
D9, D10: BAT54S; SOT-23
F1: 046701.5NRHF 1.5A; Fuse_0603_1608Metric
H1, H2, H3, H4: M3 mounting; MountingHole_3.2mm_M3
J1: SCT-013-000 ONLY; Jack_3.5mm_CUI_SJ-3523-SMT_Horizontal
J2: REGULATED 5V INPUT; TerminalBlock_Phoenix_MKDS-1,5-2_1x02_P5.00mm_Horizontal
J3: THERMAL_I2C; PinHeader_1x04_P2.54mm_Horizontal_Edge
J4: USB_C_Receptacle_USB2.0_14P; USB_C_Receptacle_Amphenol_12401948E412A_Preview
J5: TEST_LOAD; TerminalBlock_Phoenix_MKDS-1,5-2_1x02_P5.00mm_Horizontal
K1: G5LE-1 DC5; Relay_SPDT_Omron-G5LE-1
L1: 6.8uH SRP5030TA-6R8M; L_Bourns_SRP5030T
Q1, Q2: AO3400A; SOT-23
R1, R2: 1k 1%; R_0805_2012Metric_Pad1.20x1.40mm_HandSolder
R3, R4: 10k 1%; R_0805_2012Metric_Pad1.20x1.40mm_HandSolder
R6, R15: 100; R_0805_2012Metric_Pad1.20x1.40mm_HandSolder
R7, R8: 4.7k; R_0805_2012Metric_Pad1.20x1.40mm_HandSolder
R9, R21: 1k; R_0805_2012Metric_Pad1.20x1.40mm_HandSolder
R12, R16, R17, R18, R22: 330; R_0805_2012Metric_Pad1.20x1.40mm_HandSolder
R13, R14: 10k; R_0805_2012Metric_Pad1.20x1.40mm_HandSolder
R19: 22.1k; R_0805_2012Metric_Pad1.20x1.40mm_HandSolder
R20: 47.5k; R_0805_2012Metric_Pad1.20x1.40mm_HandSolder
R23: 18 ohm 1% 0.25W; R_0805_2012Metric_Pad1.20x1.40mm_HandSolder
R24, R25: 5.1k; R_0805_2012Metric_Pad1.20x1.40mm_HandSolder
R26, R27, R28: 100k; R_0805_2012Metric_Pad1.20x1.40mm_HandSolder
R29: 0R 1A min; R_0805_2012Metric
R30: 10R 1%; R_0603_1608Metric
SW2: BOOT; SW_Push_1P1T_NO_CK_KMR2
SW3: RESET; SW_Push_1P1T_NO_CK_KMR2
TP1: LOGIC_5V_FUSED; TestPoint_Pad_D1.5mm
TP2: VCC; TestPoint_Pad_D1.5mm
TP3: MCU_3V3; TestPoint_Pad_D1.5mm
TP4: ADC_3V3; TestPoint_Pad_D1.5mm
TP5: BGND; TestPoint_Pad_D1.5mm
U1: ADS1115IDGS; TSSOP-10_3x3mm_P0.5mm
U3: AP63203WU-7; TSOT-23-6
U4: ESP32-S3-WROOM-1-N16R8; ESP32_S3_WROOM_1_Edge; JLCPCB Part C2913202
U5: CP2102N-A02-GQFN28; QFN-28-1EP_5x5mm_P0.5mm_EP3.35x3.35mm

Connections:
ADC_3V3: C3.1, C4.1, D9.2 (K), D10.2 (K), R3.1, R30.2, TP4.1 (1_1), U1.8 (VDD)
ADC_AIN0: C1.1, D9.3 (COM), R1.2, U1.4 (AIN0)
ADC_AIN1: C1.2, D10.3 (COM), R2.2, U1.5 (AIN1)
ADC_LED_A: D2.2 (A), R9.2
BGND: C2.2, C3.2, C4.2, C5.2, C6.2, C7.2, C8.2, C9.2, C10.2, C11.2, C15.2, C16.2, C17.2, C18.2, C19.2, C20.2, C22.2, C23.2, C24.2, D2.1 (K), D5.1 (K), D6.4 (GK), D6.5 (RK), D6.6 (BK), D7.1 (A), D8.1 (K), D9.1 (A), D10.1 (A), J2.1, J3.3, J4.A1 (GND), J4.A12 (GND), J4.B1 (GND), J4.B12 (GND), J4.SH (SHIELD), Q1.2 (S), Q2.2 (S), R4.2, R20.2, R24.2, R25.2, R26.2, R27.2, R28.2, SW2.1, SW3.1, TP5.1 (1_1), U1.1 (ADDR), U1.3 (GND), U1.6 (AIN2), U1.7 (AIN3), U3.4 (GND), U4.1 (GND), U4.40 (GND), U4.41 (GND), U5.3 (GND), U5.29 (GND)
BOOT: R14.2, SW2.2, U4.27 (IO0)
BUCK_BST: C21.1, U3.6 (BST)
BUCK_SW: C21.2, L1.1, U3.5 (SW)
BUZZER_DRIVE: R15.1, U4.5 (IO5)
BUZZER_LOW: BZ1.2 (-), Q2.3 (D)
CTL: R6.1, R27.1, U4.4 (IO4)
CT_BIAS: C2.1, J1.S, R2.1, R3.2, R4.1, R23.2
CT_HI: J1.T, R1.1, R23.1
EN: C11.1, R13.2, SW3.2, U4.3 (EN)
LED_B: R18.1, U4.12 (IO8)
LED_B_A: D6.1 (BA), R18.2
LED_G: R17.1, U4.7 (IO7)
LED_G_A: D6.3 (GA), R17.2
LED_R: R16.1, U4.6 (IO6)
LED_R_A: D6.2 (RA), R16.2
LOAD_IN: J5.1, K1.1
LOAD_OUT: J5.2, K1.3
LOGIC_5V_FUSED: C5.1, C6.1, C19.1, C20.1, C22.1, C24.1, D1.1 (K), F1.2, K1.5, TP1.1 (1_1), U3.2 (EN), U3.3 (IN)
LOGIC_5V_IN: F1.1, J2.2
MCU_3V3: BZ1.1 (+), C9.1, C10.1, C23.1, J3.4, R7.1, R8.1, R12.1, R13.1, R14.1, R29.2, TP3.1 (1_1), U4.2 (3V3)
unnamed: D5.2 (A), R12.2
unnamed: Q2.1 (G), R15.2, R26.1
RELAY_GATE: Q1.1 (G), R6.2, R28.1
RELAY_LOW: D1.2 (A), K1.2, Q1.3 (D)
RX: U4.37 (TXD0), U5.25 (RXD)
SCL: J3.2, R7.2, U1.10 (SCL), U4.38 (IO2)
SDA: J3.1, R8.2, U1.9 (SDA), U4.18 (IO10)
TX: U4.36 (RXD0), U5.26 (TXD)
USB_CC1: J4.A5 (CC1), R24.1
USB_CC2: J4.B5 (CC2), R25.1
USB_D+: D7.2 (K), J4.A6 (D+), J4.B6 (D+), U5.4 (D+)
USB_D-: D7.3 (K), J4.A7 (D-), J4.B7 (D-), U5.5 (D-)
USB_LED_A: D8.2 (A), R22.2
USB_RESET: R21.2, U5.9 (~RST)
USB_VBUS: D7.4 (K), J4.A4 (VBUS), J4.A9 (VBUS), J4.B4 (VBUS), J4.B9 (VBUS), R19.1
USB_VBUS_SENSE: R19.2, R20.1, U5.8 (VBUS)
VCC: C7.1, C8.1, C15.1, C16.1, C17.1, C18.1, L1.2, R9.1, R21.1, R22.1, R29.1, R30.1, TP2.1 (1_1), U3.1 (FB), U5.6 (VDD), U5.7 (VREGIN)

Notes on the sheet:
01 POWER / 5 V TO 3.3 V
J2 regulated 5 V only. Buck + local reservoirs. Not battery charging.
02 USB / UART PROGRAMMING
USB is data only; J2 powers the board. Hold BOOT, pulse RESET.
03 ESP32-S3 / BOOT / RESET
ESP32-S3-WROOM-1-N16R8. Module RF keepout on every copper layer.
04 CT / ADC ANALOG FRONT END
AC current transformer only. Differential AIN0-AIN1, address 0x48.
05 RELAY / TEST LOAD
Normally-open dry contact loop. 5-24 V DC / 1 A resistive bench target.
06 INDICATORS / EXTERNAL I2C
3.3 V logic only. Buzzer part selection and bench measurements pending.
MECHANICAL + MEASUREMENT POINTS

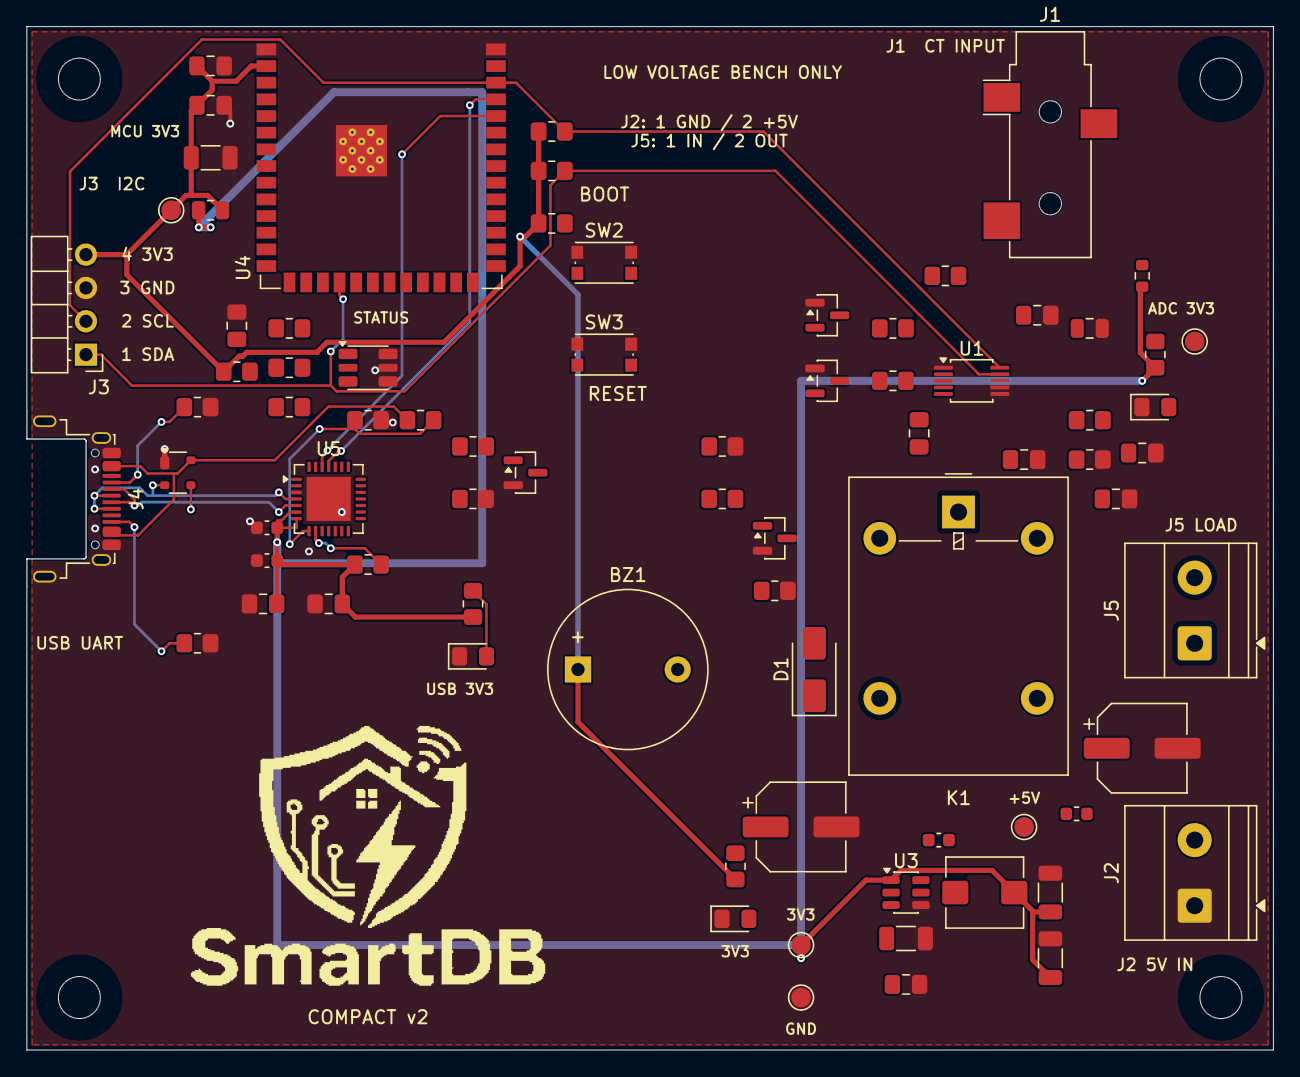
[picture p108: board smart_db_v2/smart_db/work/full_routing_backup/smart_db.kicad_pcb from above]

Board: 4 copper layers, 95.0 x 78.0 mm, 82 parts (0 on the bottom side), 42 nets.
