c-lydia/SmartDB/smart_db/smart_db.kicad_pcb

## KiCad design smart_db/smart_db.kicad_pcb (2026-08-03, an earlier design)

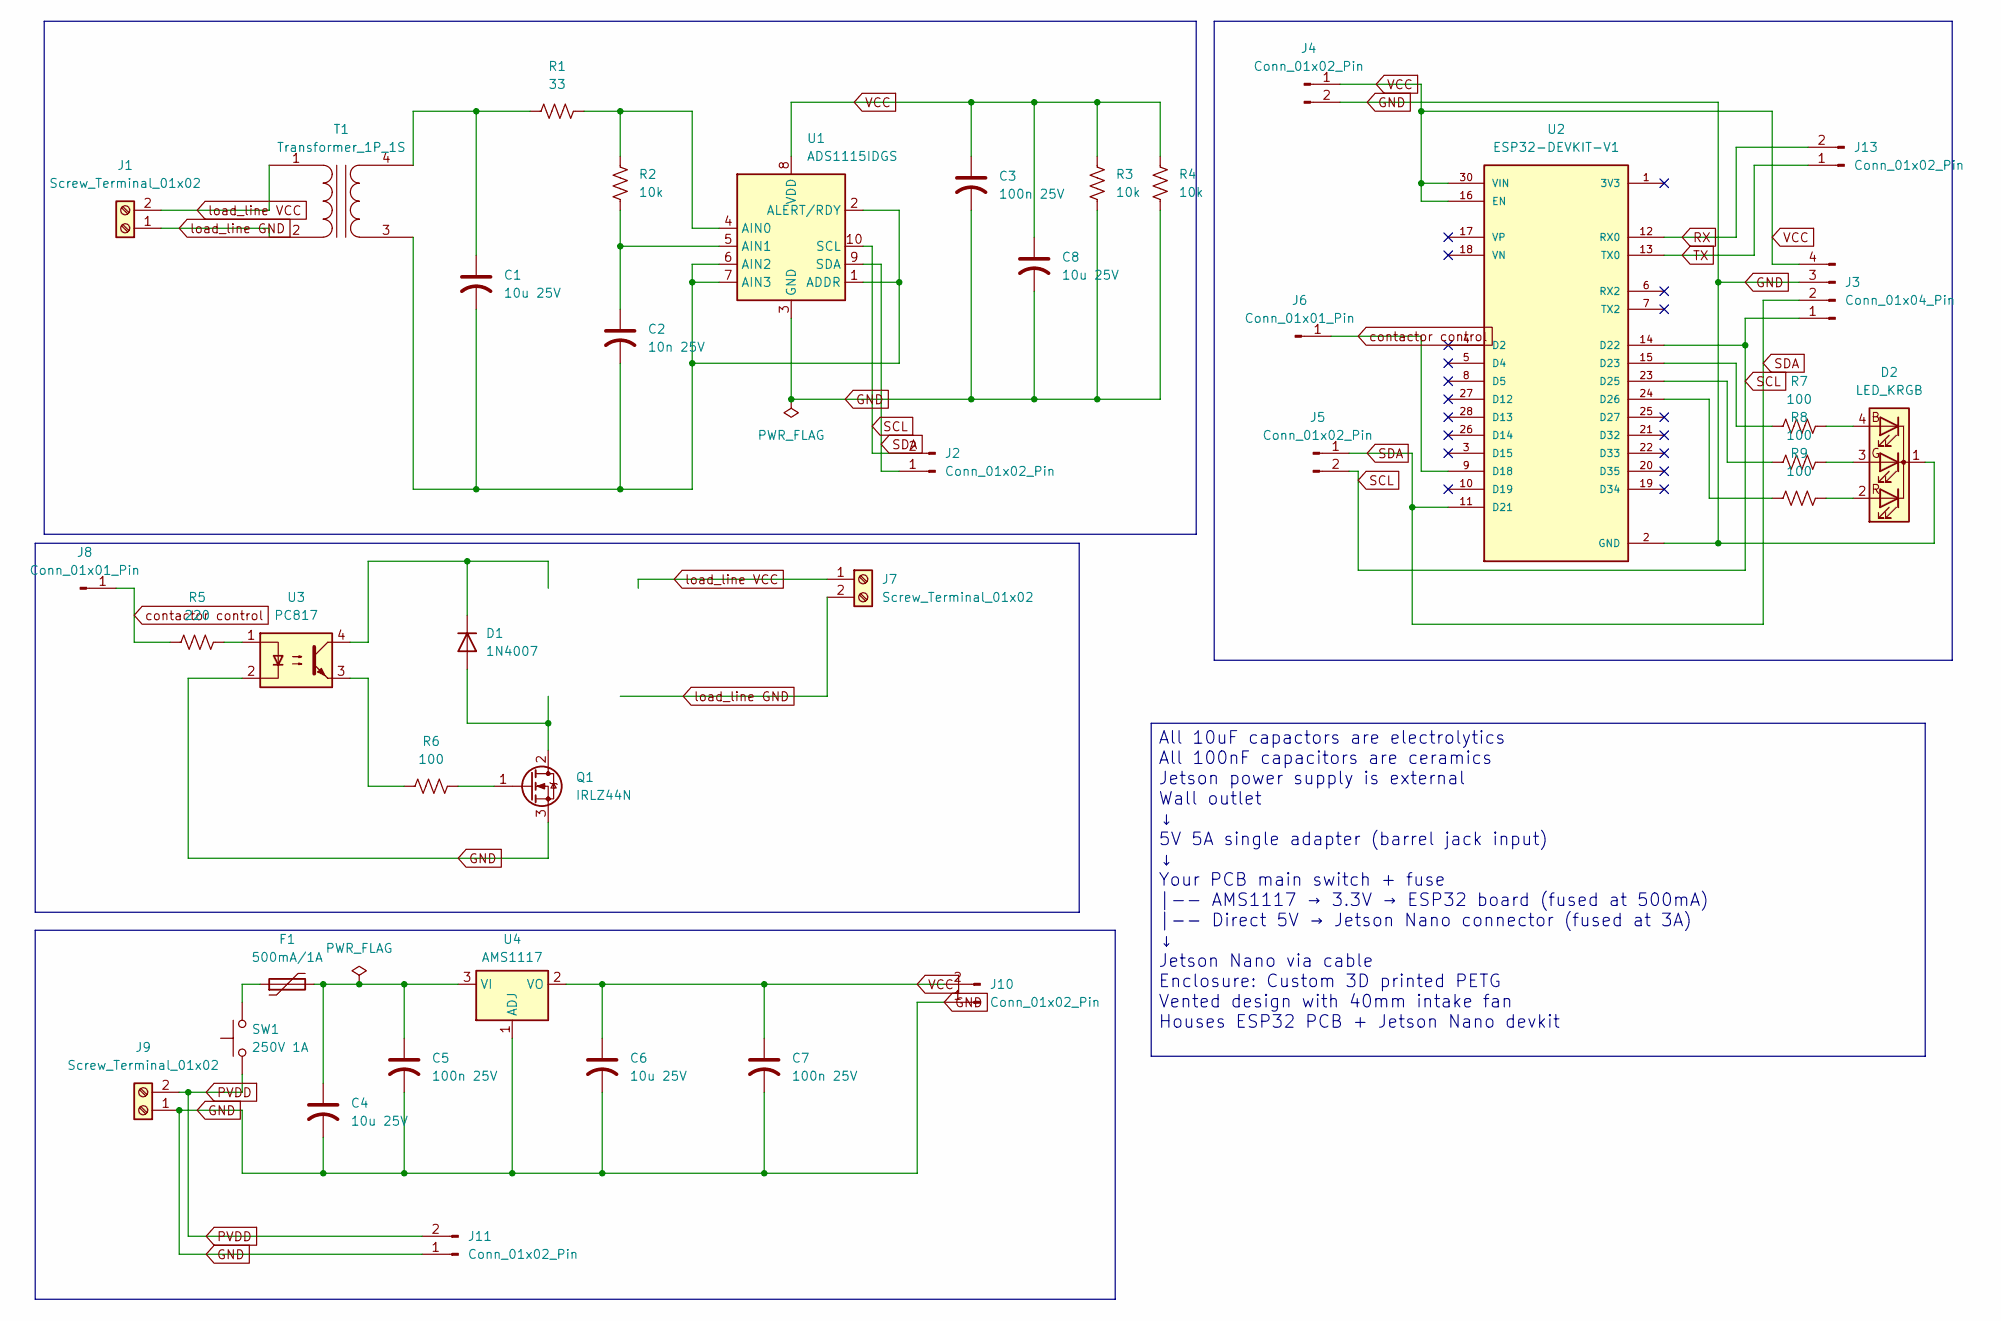
[picture p109: schematic smart_db.kicad_sch]

Parts:
C1, C4, C6, C8: 10u 25V; CP_Radial_D5.0mm_P2.50mm
C2: 10n 25V; C_Disc_D3.0mm_W1.6mm_P2.50mm
C3, C5, C7: 100n 25V; C_Disc_D3.0mm_W1.6mm_P2.50mm
D1: 1N4007; D_DO-41_SOD81_P10.16mm_Horizontal
D2: LED_KRGB; LED_D5.0mm-4_RGB
F1: 500mA/1A; Fuse_Bourns_MF-RHT050
J1, J7, J9: Screw_Terminal_01x02; TerminalBlock_RND_205-00276_1x02_P5.00mm_Vertical
J2, J4, J5, J10, J11, J13: Conn_01x02_Pin; PinHeader_1x02_P2.54mm_Vertical
J3: Conn_01x04_Pin; PinHeader_1x04_P2.54mm_Vertical
J6, J8: Conn_01x01_Pin; PinHeader_1x01_P2.54mm_Vertical
Q1: IRLZ44N; TO-220-3_Vertical
R1: 33; R_Axial_DIN0207_L6.3mm_D2.5mm_P10.16mm_Horizontal
R2, R3, R4: 10k; R_Axial_DIN0204_L3.6mm_D1.6mm_P7.62mm_Horizontal
R5: 220; R_Axial_DIN0204_L3.6mm_D1.6mm_P2.54mm_Vertical
R6: 100; R_Axial_DIN0204_L3.6mm_D1.6mm_P2.54mm_Vertical
R7, R8, R9: 100; R_Axial_DIN0204_L3.6mm_D1.6mm_P7.62mm_Horizontal
SW1: 250V 1A; SW_PUSH_1P1T_6x3.5mm_H5.0_APEM_MJTP1250
T1: Transformer_1P_1S; TerminalBlock_RND_205-00278_1x04_P5.00mm_Vertical
U1: ADS1115IDGS; TSSOP-10_3x3mm_P0.5mm
U2: ESP32-DEVKIT-V1; MODULE_ESP32_DEVKIT_V1; PARTREV N/A
U3: PC817; DIP-4_W7.62mm
U4: AMS1117; SOT-223-3_TabPin2

Connections:
GND: C3.2, C4.2, C5.2, C6.2, C7.2, C8.2, D2.1 (K), J3.3, J4.2, J9.1, J10.1, J11.1, Q1.3 (S), R3.2, R4.2, U1.3 (GND), U2.2 (GND), U2.29 (GND), U3.2, U4.1 (ADJ); also elsewhere on the board
unnamed 1: D1.2 (A), Q1.2 (D); also elsewhere on the board
unnamed 2: D1.1 (K), U3.4; also elsewhere on the board
unnamed: D2.4 (BA), R7.2
unnamed: D2.3 (GA), R8.2
unnamed: D2.2 (RA), R9.2
unnamed: F1.1, SW1.2
unnamed: Q1.1 (G), R6.1
unnamed: R5.2, U3.1
unnamed: R6.2, U3.3
unnamed: C1.2, C2.2, T1.3 (SA), U1.1 (ADDR), U1.2 (ALERT/RDY), U1.6 (AIN2), U1.7 (AIN3)
unnamed: C1.1, R1.1, T1.4 (SB)
unnamed: R1.2, R2.1, U1.4 (AIN0)
unnamed: C2.1, R2.2, U1.5 (AIN1)
unnamed: R7.1, U2.15 (D23)
unnamed: R8.1, U2.23 (D25)
unnamed: R9.1, U2.24 (D26)
unnamed: C4.1, C5.1, F1.2, U4.3 (VI)
PVDD: J9.2, J11.2, SW1.1; also elsewhere on the board
RX: J13.2, U2.12 (RX0)
SCL: J2.2, J3.1, J5.2, U1.10 (SCL), U2.14 (D22)
SDA: J2.1, J3.2, J5.1, U1.9 (SDA), U2.11 (D21)
TX: J13.1, U2.13 (TX0)
VCC: C3.1, C6.1, C7.1, C8.1, J3.4, J4.1, J10.2, R3.1, R4.1, U1.8 (VDD), U2.16 (EN), U2.30 (VIN), U4.2 (VO)
contactor control: J6.1 (Pin_1_1), J8.1 (Pin_1_1), R5.1, U2.9 (D18)
load_line GND: J1.1, J7.2, T1.2 (AB); also elsewhere on the board
load_line VCC: J1.2, J7.1, T1.1 (AA); also elsewhere on the board

Notes on the sheet:
All 10uF capactors are electrolytics All 100nF capacitors are ceramics Jetson power supply is external Wall outlet ↓ 5V 5A single adapter (barrel jack input) ↓ Your PCB main switch + fuse |-- AMS1117 → 3.3V → ESP32 board (fused at 500mA) |-- Direct 5V → Jetson Nano connector (fused at 3A) ↓ Jetson 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

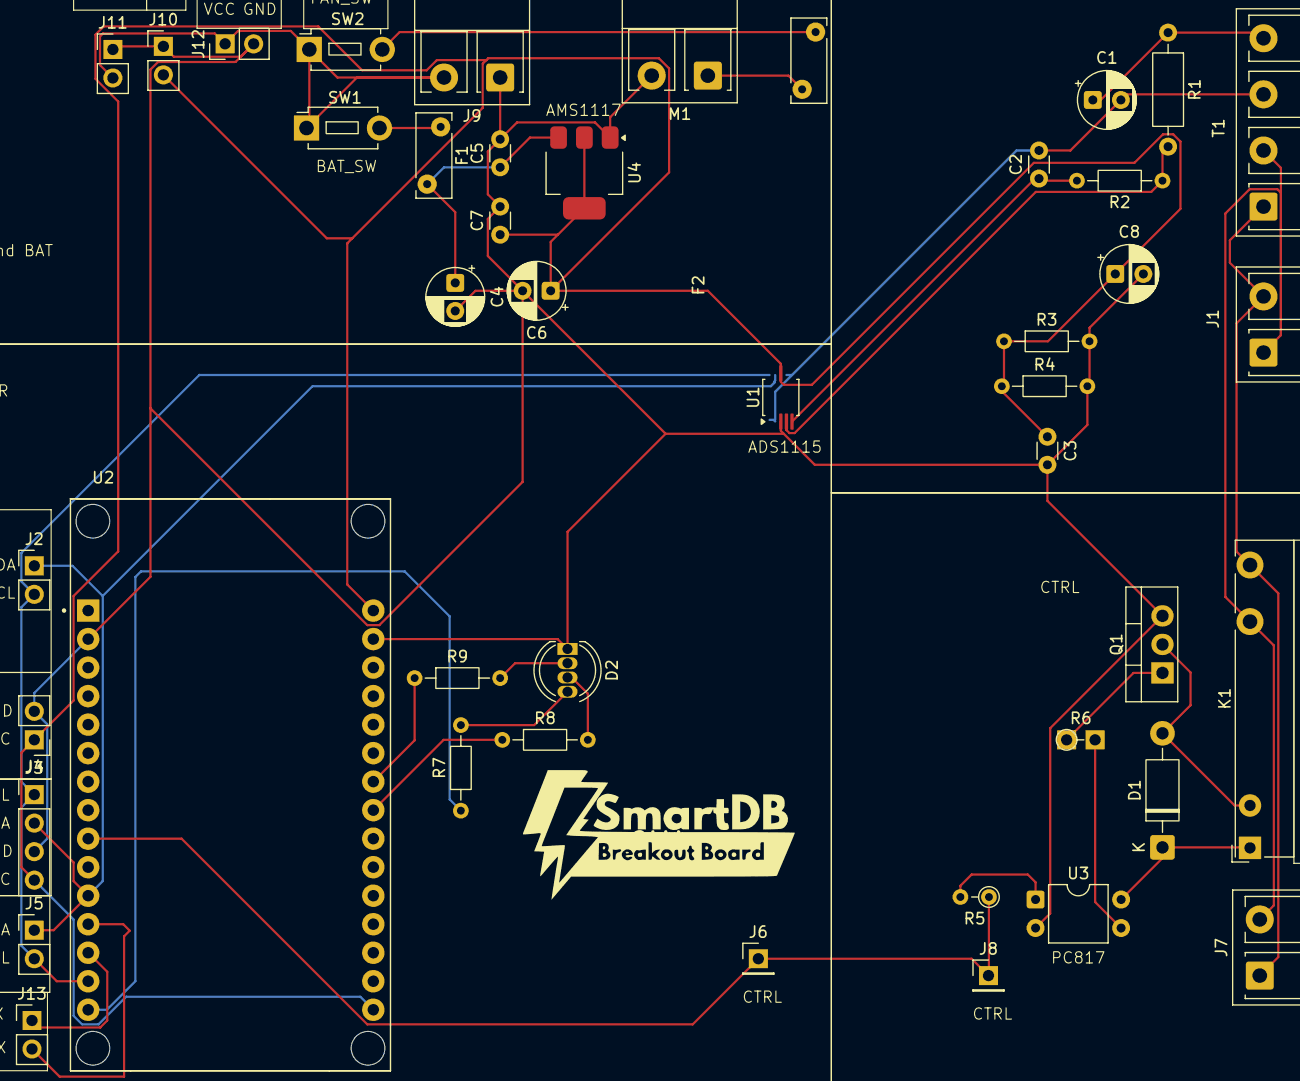
[picture p110: board smart_db/smart_db.kicad_pcb from above]

Board: 2 copper layers, 44 parts (0 on the bottom side), 29 nets.

Other parts of the board:
F2: 200mA/400mA; Fuse_Bourns_MF-RHT050
J12: Conn_01x02_Pin; PinHeader_1x02_P2.54mm_Vertical
K1: Fujitsu_FTR-LYAA005x; Relay_SPST-NO_Fujitsu_FTR-LYAA005x_FormA_Vertical
M1: 5V 0.1A; TerminalBlock_RND_205-00276_1x02_P5.00mm_Vertical
SW2: 250V 1A; SW_PUSH_1P1T_6x3.5mm_H5.0_APEM_MJTP1250

Their connections:
GND: J12.2, M1.2 (-); also elsewhere on the board
unnamed 1: K1.A2; also elsewhere on the board
unnamed 2: K1.A1; also elsewhere on the board
unnamed: F2.2, SW2.2
unnamed: F2.1, M1.1 (+)
PVDD: J12.1, SW2.1; also elsewhere on the board
load_line GND: K1.13; also elsewhere on the board
load_line VCC: K1.14; also elsewhere on the board
