c-lydia/SmartDB/esp_idf/blink/main/main.c

#include <stdio.h>
#include "freertos/FreeRTOS.h"
#include "freertos/task.h"
#include "driver/gpio.h"

#define LED_GPIO GPIO_NUM_2

void app_main(void) {
    gpio_reset_pin(LED_GPIO);
    gpio_set_direction(LED_GPIO, GPIO_MODE_OUTPUT);

    while (1) {
        gpio_set_level(LED_GPIO, 1);
        vTaskDelay(pdMS_TO_TICKS(1000));

        gpio_set_level(LED_GPIO, 0);
        vTaskDelay(pdMS_TO_TICKS(1000));
    }
}
