c-lydia/SmartDB/(commit log)

2026-07-13 add more ref
    [app_update_err_codes.csv, bootloader_support_err_codes.csv, efuse_err_codes.csv, esp-tls_err_codes.csv, esp_common_err_codes.csv, esp_http_client_err_codes.csv, esp_http_server_err_codes.csv, esp_https_ota_err_codes.csv]
2026-07-20 update git ignore, add blink led
2026-10-10 docs: link SmartDB docs, PCB/API guides and ByteLab web project
